galan-e/Tarjeta_v02/README.md

# Tarjeta_v02
<pre>Segunda Revision para la tarjeta de desarrollo con FPGA Spartan 6 
Los cambios realizados se centran en:
<ul>
<li> cambio de la IMU
<li> Agrego una tolerancia en borde de la tarjet
<li> Se agrandaron los agujeros de montaje.
<li> Acomodo de capacitores en alimentacion de cada banco del FPGA 
<li> Acomodo de capacitores en la alimentacion de todos los componentes.
</ul>
</pre>
<pre>Se han revisado y corregido los errores en el pcb

<ul>
<li> Trazos pequeños
<li> Trazos cerca de vias
<li> Tolerancia en tre trazos
<li> Nets no conectadas
</ul>
</pre>
