galan-e/Tarjeta_v02/KiCad-project/obi1/README.md

# KiCad Project

The file obi.sch is the main schematic sheet and contains the links to the schematic sheets of all components.
