galan-e/Tarjeta_v02/BOM_Tarjetav2.xlsx

Número de pieza del fabricante | Fabricante | Número de pieza de Digi-Key | Referencia del cliente | Designador de referencia | Embalaje | Estado de la pieza | Cantidad | Precio unitario | Precio total | Cantidad disponible | Tiempo esper. de fabricación: | Descripción | Estado RoHS | Estado Libre de plomo | Estatus REACH
AZ1117EH-3.3TRG1 | Diodes Incorporated | AZ1117EH-3.3TRG1DICT-ND |  |  | Cinta cortada (CT) | Última compra | 3 | 0.44 | $1.32 | 1476 | 17 Semanas | IC REG LINEAR 3.3V 1A SOT223 | Cumple con RoHS3 | Sin plomo | No afectado por REACH
AZ1117EH-1.2TRG1 | Diodes Incorporated | AZ1117EH-1.2TRG1DICT-ND |  |  | Cinta cortada (CT) | Última compra | 3 | 0.44 | $1.32 | 35 | 13 Semanas | IC REG LINEAR 1.2V 1A SOT223 | Cumple con RoHS3 | Sin plomo | No afectado por REACH
MCP4922T-E/ST | Microchip Technology | MCP4922T-E/STCT-ND |  |  | Cinta cortada (CT) | Activo | 3 | 2.75 | $8.25 | 8 | 38 Semanas | IC DAC 12BIT V-OUT 14TSSOP | Cumple con RoHS3 | Sin plomo | No afectado por REACH
ADC122S625CIMM/NOPB | Texas Instruments | ADC122S625CIMM/NOPBCT-ND |  |  | Cinta cortada (CT) | Activo | 3 | 6.94 | $20.82 | 1016 | 6 Semanas | IC ADC 12BIT SAR 10VSSOP | Cumple con RoHS3 | Sin plomo | No afectado por REACH
CY62157EV30LL-45ZSXIT | Cypress Semiconductor Corp | 428-3574-1-ND |  |  | Cinta cortada (CT) | Activo | 3 | 9.55 | $28.65 | 2251 | 15 Semanas | IC SRAM 8MBIT PARALLEL 44TSOP II | Cumple con RoHS3 | Sin plomo | No afectado por REACH
S25FL064LABMFM013 | Cypress Semiconductor Corp | 428-S25FL064LABMFM013CT-ND |  |  | Cinta cortada (CT) | Activo | 3 | 3.18 | $9.54 | 3306 | 20 Semanas | IC FLASH 64MBIT SPI/QUAD 8SOIC | Cumple con RoHS3 | Sin plomo | No afectado por REACH
CL21A475KQFNNNG | Samsung Electro-Mechanics | 1276-6465-1-ND |  |  | Cinta cortada (CT) | Activo | 60 | 0.0528 | $3.16 | 166338 | 28 Semanas | CAP CER 4.7UF 6.3V X5R 0805 | Cumple con RoHS3 | Sin plomo | No afectado por REACH
CL05A474KQ5NNNC | Samsung Electro-Mechanics | 1276-1479-1-ND |  |  | Cinta cortada (CT) | Activo | 60 | 0.0342 | $2.05 | 688810 | 28 Semanas | CAP CER 0.47UF 6.3V X5R 0402 | Cumple con RoHS3 | Sin plomo | No afectado por REACH
CL32A107MQVNNNE | Samsung Electro-Mechanics | 1276-1092-1-ND |  |  | Cinta cortada (CT) | Activo | 15 | 0.499 | $7.48 | 447304 | 28 Semanas | CAP CER 100UF 6.3V X5R 1210 | Cumple con RoHS3 | Sin plomo | No afectado por REACH
C0805Y103K9RAC7800 | KEMET | 399-17649-1-ND |  |  | Cinta cortada (CT) | Activo | 3 | 0.43 | $1.29 | 2081 | 20 Semanas | CAP CER SMD 0805 .01UF 6.3V 10% | Cumple con RoHS3 | Sin plomo | No afectado por REACH
CL21A106MQFNNNE | Samsung Electro-Mechanics | 1276-1298-1-ND |  |  | Cinta cortada (CT) | Activo | 3 | 0.11 | $0.33 | 1153 | 28 Semanas | CAP CER 10UF 6.3V X5R 0805 | Cumple con RoHS3 | Sin plomo | No afectado por REACH
08056D104KAT2A | AVX Corporation | 478-08056D104KAT2ACT-ND |  |  | Cinta cortada (CT) | Activo | 10 | 0.067 | $0.67 | 27701 | 16 Semanas | CAP CER 0.1UF 6.3V X5R 0805 | Cumple con RoHS3 | No disponible | No afectado por REACH
0603ZC124KAT2A | AVX Corporation | 478-1240-1-ND |  |  | Cinta cortada (CT) | Activo | 3 | 0.35 | $1.05 | 3499 | 24 Semanas | CAP CER 0.12UF 10V X7R 0603 | Cumple con RoHS3 | Sin plomo | No afectado por REACH
885012206013 | Würth Elektronik | 732-7932-1-ND |  |  | Cinta cortada (CT) | Activo | 10 | 0.021 | $0.21 | 4040 | 27 Semanas | CAP CER 6800PF 10V X7R 0603 | Cumple con RoHS3 | Sin plomo | No afectado por REACH
74LVC4245APW,118 | Nexperia USA Inc. | 1727-4308-1-ND |  |  | Cinta cortada (CT) | Activo | 6 | 0.59 | $3.54 | 18125 | 16 Semanas | IC TRNSLTR BIDIRECTIONAL 24TSSOP | Cumple con RoHS3 | Sin plomo | No afectado por REACH
XLH536060.000000I | Renesas Electronics America Inc | 631-1167-ND |  |  | Tira | Activo | 3 | 2 | $6.00 | 1717 | 20 Semanas | XTAL OSC XO 60.0000MHZ HCMOS SMD | Cumple con RoHS3 | Sin plomo | No afectado por REACH
10118193-0001LF | Amphenol ICC (FCI) | 609-4616-1-ND |  |  | Cinta cortada (CT) | Activo | 3 | 0.44 | $1.32 | 75865 | 14 Semanas | CONN RCPT USB2.0 MICRO B SMD R/A | Cumple con RoHS | Sin plomo | No afectado por REACH
PTS647SN38SMTR2LFS | C&K | PTS647SN38SMTR2LFSCT-ND |  |  | Cinta cortada (CT) | Activo | 6 | 0.18 | $1.08 | 77248 | 13 Semanas | TACT 4.5 X 4.5, 3.8 MM H, 1.0N, | Cumple con RoHS3 | Sin plomo | No disponible
CC0805KKX5R5BB105 | Yageo | 311-3417-1-ND |  |  | Cinta cortada (CT) | Activo | 50 | 0.0802 | $4.01 | 831 | 24 Semanas | CAP CER 1UF 6.3V X5R 0805 | Cumple con RoHS3 | Sin plomo | No afectado por REACH
CRCW08051M00FKEAHP | Vishay Dale | 541-1.00MTCT-ND |  |  | Cinta cortada (CT) | Activo | 3 | 0.26 | $0.78 | 8909 | 46 Semanas | RES SMD 1M OHM 1% 1/2W 0805 | Cumple con RoHS3 | Sin plomo | No disponible
RNCP0805FTD100R | Stackpole Electronics Inc | RNCP0805FTD100RCT-ND |  |  | Cinta cortada (CT) | Activo | 100 | 0.0283 | $2.83 | 233538 | 15 Semanas | RES 100 OHM 1% 1/4W 0805 | Cumple con RoHS3 | Sin plomo | No afectado por REACH
SG73S2ATTD4701F | KOA Speer Electronics, Inc. | 2019-SG73S2ATTD4701FCT-ND |  |  | Cinta cortada (CT) | Activo | 27 | 0.158 | $4.26 | 19836 | 8 Semanas | RES 4.7K OHM 1% 1/4W 0805 | Cumple con RoHS3 | Sin plomo | No afectado por REACH
RC0805FR-7W330RL | Yageo | 13-RC0805FR-7W330RLCT-ND |  |  | Cinta cortada (CT) | Activo | 3 | 0.18 | $0.54 | 6247 | 20 Semanas | RES 330 OHM 1% 1/4W 0805 | Cumple con RoHS3 | No disponible | No afectado por REACH
RK73B2ATTD510J | KOA Speer Electronics, Inc. | 2019-RK73B2ATTD510JCT-ND |  |  | Cinta cortada (CT) | Activo | 18 | 0.028 | $0.50 | 2213 | 7 Semanas | RES 51 OHM 5% 1/4W 0805 | Cumple con RoHS3 | Sin plomo | No afectado por REACH
RNCP0805FTD20R0 | Stackpole Electronics Inc | RNCP0805FTD20R0CT-ND |  |  | Cinta cortada (CT) | Activo | 24 | 0.07 | $1.68 | 31805 | 15 Semanas | RES 20 OHM 1% 1/4W 0805 | Cumple con RoHS3 | Sin plomo | No afectado por REACH
RK73H2ATTD2401F | KOA Speer Electronics, Inc. | 2019-RK73H2ATTD2401FCT-ND |  |  | Cinta cortada (CT) | Activo | 3 | 0.1 | $0.30 | 87 | 7 Semanas | RES 2.4K OHM 1% 1/4W 0805 | Cumple con RoHS3 | Sin plomo | No afectado por REACH
CRS0805-FX-10R0ELF | Bourns Inc. | CRS0805-FX-10R0ELFCT-ND |  |  | Cinta cortada (CT) | Activo | 3 | 0.21 | $0.63 | 15458 | 18 Semanas | RES SMD 10 OHM 1% 1/4W 0805 | Cumple con RoHS3 | Sin plomo | No afectado por REACH
LSM6DSMTR | STMicroelectronics | 497-16696-1-ND |  |  | Cinta cortada (CT) | Activo | 3 | 3.09 | $9.27 | 30433 | 34 Semanas | IMU ACCEL/GYRO I2C/SPI 14LGA | Cumple con RoHS3 | Sin plomo | No afectado por REACH
XC6SLX16-3FTG256I | Xilinx Inc. | 122-1730-ND |  |  | Bandeja | Activo | 3 | 41.86 | $125.58 | 2099 | 52 Semanas | IC FPGA 186 I/O 256FTBGA | Cumple con RoHS3 | Sin plomo | No afectado por REACH
DS01C-254-S-08BE | CUI Devices | 2223-DS01C-254-S-08BE-ND |  |  | Tubo | Activo | 3 | 0.66 | $1.98 | 325 | 8 Semanas | DIP SWITCH, SPST, 2.54 PITCH, RA | Cumple con RoHS | Sin plomo | No disponible
APG1608ZGCK | Kingbright | 754-2113-1-ND |  |  | Cinta cortada (CT) | Activo | 27 | 0.386 | $10.42 | 16355 | 8 Semanas | LED GREEN CLEAR 0603 SMD | Cumple con RoHS3 | Sin plomo | No afectado por REACH
RNCP0805FTD10K0 | Stackpole Electronics Inc | RNCP0805FTD10K0CT-ND |  |  | Cinta cortada (CT) | Activo | 10 | 0.07 | $0.70 | 147261 | 15 Semanas | RES 10K OHM 1% 1/4W 0805 | Cumple con RoHS3 | Sin plomo | No afectado por REACH
