galan-e/Tarjeta_v02/Component_List.ods

Sheet: Hoja1
Componente | Nombre | Pines | Comp. Req. | Link
Regulador 3.3V | AZ1117E3.3 | 3 | 2X1.0uF | https://www.digikey.com.mx/product-detail/es/AZ1117EH-3.3TRG1/AZ1117EH-3.3TRG1DICT-ND/5001336/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
Regulador 1.2V | AZ1117E1.2 | 3 | 2X1.0uF | https://www.digikey.com.mx/product-detail/es/AZ1117EH-1.2TRG1/AZ1117EH-1.2TRG1DICT-ND/5001340/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
Flash SOIC8 | S25FL064LABMFI013 | 8 |  | https://www.digikey.com.mx/product-detail/es/S25FL064LABMFI013/428-4073-1-ND/7318403/?itemSeq=302380495
FPGA | XC6SLX16-2FTG256C | 186 |  | https://www.digikey.com.mx/product-detail/es/XC6SLX16-2FTG256C/122-1672-ND/2408282/?itemSeq=302162759
IMU | BMX055 | 20 | 2x100nF | https://www.digikey.com.mx/product-detail/es/BMX055/828-1060-1-ND/6136311/?itemSeq=302382329
DAC | MCP4922T-E/ST | 14 | 0.1uF ceramic, 10uF tantalum in parallel | https://www.digikey.com.mx/product-detail/es/MCP4922T-E%2FST/MCP4922T-E%2FSTCT-ND/736004/?itemSeq=302284305
ADC | ADC122S625CIMM/NOPB | 10 | 2x10uF, 2x0.1uF | https://www.digikey.com.mx/product-detail/es/ADC122S625CIMM%2FNOPB/ADC122S625CIMM%2FNOPBCT-ND/1823877/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
ADC-OK | ADC122S021CIMM/NOPB |  |  | https://www.digikey.com.mx/product-detail/es/texas-instruments/ADC122S021CIMM-NOPB/ADC122S021CIMM-NOPBTR-ND/755010
RAM | CY62157EV30LL-45ZSXA | 44 |  | https://www.digikey.com.mx/product-detail/es/cypress-semiconductor-corp/CY7C1041GN30-10BVXI/2015-CY7C1041GN30-10BVXI-ND/9771559
FLASH Adesto Recomendada | AT45DB161E-SSHF2B-T | 8 |  | https://www.digikey.com.mx/product-detail/es/AT45DB161E-MHF2B-T/1265-1040-1-ND/3986539/?itemSeq=302596312
Capacitores Desacoplo Ver ug393_pag14 | CL21A475KQFNNNG CAP CER 4.7UF 6.3V X5R 0805 | 10x2 | 4.7uF | https://www.digikey.com.mx/ordering/shoppingcart?qty=5&cref=&enterprise=0&part=1276-6465-1-ND&partid=5958093
 | CL05A474KQ5NNNC CAP CER 0.47UF 6.3V X5R 0402 | 9x2 | 0.47uF | https://www.digikey.com.mx/product-detail/es/samsung-electro-mechanics/CL05A474KQ5NNNC/1276-1479-1-ND/3889565
 | CL32A107MQVNNNE CAP CER 100UF 6.3V X5R 1210 | 5x2 | 100uF | https://www.digikey.com.mx/product-detail/es/samsung-electro-mechanics/CL32A107MQVNNNE/1276-1092-1-ND/3889178
DIP Switch 8 | 206-8 | 16 |  | https://www.digikey.com.mx/product-detail/es/206-8/CT2068-ND/20760/?itemSeq=303884575
Variador de Nivel | 74LVC4245APW,118‎ | 24 |  | https://www.digikey.com.mx/product-detail/es/74LVC4245APW%2C118/1727-4308-1-ND/2209918/?itemSeq=304138377
Cristal | XLH536060.000000I‎ | 6 |  | https://www.digikey.com.mx/product-detail/es/XLH536060.000000I/631-1167-ND/2074695/?itemSeq=305209256
RAM2 | IS61WV25616EDBLL-10TLI‎ | 44 |  | https://www.digikey.com.mx/product-detail/es/IS61WV25616EDBLL-10TLI/706-1146-ND/2799144/?itemSeq=303374271
Terminales | OSTTC022162 | 2 |  | https://www.digikey.com.mx/product-detail/es/on-shore-technology-inc/OSTTC022162/ED2609-ND/614558
Micro usb conector | 10118193-0001LF | 5 |  | https://www.digikey.com.mx/product-detail/es/amphenol-icc-fci/10118193-0001LF/609-4616-1-ND/2785380
boton pulsador |  | 4 |  | https://www.digikey.com.mx/product-detail/es/PTS+647+SN38+SMTR2+LFS/PTS647SN38SMTR2LFSCT-ND/9649869/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
Led Verde |  | 2 |  | https://www.digikey.com.mx/product-detail/es/LTST-C191KGKT/160-1446-1-ND/386834/?itemSeq=303514635
Led Rojo |  | 2 |  | https://www.digikey.com.mx/product-detail/es/LTST-C191KRKT/160-1447-1-ND/386836/?itemSeq=303514649
Led Azul |  | 2 |  | https://www.digikey.com.mx/product-detail/es/LTST-C191TBKT/160-1647-1-ND/573587/?itemSeq=303514652

Sheet: BOM
Componente | @Caracteristica | Numero de parte | Link | Precio | Precio x10 | Reemplazo | Comp. Req. | Link | Precio Unitario | Precio x 5 | Precio x10
Regulador lineal | IC REG LINEAR 3.3V 1A SOT223 | AZ1117E3.3 | https://www.digikey.com.mx/product-detail/es/AZ1117EH-3.3TRG1/AZ1117EH-3.3TRG1DICT-ND/5001336/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 | $0.4400 | $0.3300
Regulador lineal | IC REG LINEAR 1.2V 1A SOT223 | AZ1117E1.2 | https://www.digikey.com.mx/product-detail/es/AZ1117EH-1.2TRG1/AZ1117EH-1.2TRG1DICT-ND/5001340/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 | $0.4400 | $0.3300
Flash | IC FLASH 64MBIT SPI/QUAD 8SOIC | S25FL064LABMFI013 | https://www.digikey.com.mx/product-detail/es/S25FL064LABMFI013/428-4073-1-ND/7318403/?itemSeq=302380495 | $1.4300 | $1.3040
FPGA | IC FPGA 186 I/O 256FTBGA | XC6SLX16-2FTG256C | https://www.digikey.com.mx/product-detail/es/XC6SLX16-2FTG256C/122-1672-ND/2408282/?itemSeq=302162759 | $26.4600 | $0.0000
IMU | Acelerómetro, giroscopio, magnetómetro, 9 ejes Sensor I²C, UART Salida | BMX055 | https://www.digikey.com.mx/product-detail/es/BMX055/828-1060-1-ND/6136311/?itemSeq=302382329 | $0.0000 | $0.0000 | BMF055 |  | https://www.digikey.com.mx/es/products/detail/bosch-sensortec/BMF055/6136302 | $10.9700 | $9.6240 | $8.6620
DAC | IC DAC 12BIT V-OUT 14TSSOP | MCP4922T-E/ST | https://www.digikey.com.mx/product-detail/es/MCP4922T-E%2FST/MCP4922T-E%2FSTCT-ND/736004/?itemSeq=302284305 | $2.7500 | $0.0000
ADC | IC ADC 12BIT SAR 10VSSOP | ADC122S625CIMM/NOPB | https://www.digikey.com.mx/product-detail/es/ADC122S625CIMM%2FNOPB/ADC122S625CIMM%2FNOPBCT-ND/1823877/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 | $6.9400 | $6.2670
ADC | IC ADC 12BIT SAR 8VSSOP | ADC122S021CIMM/NOPB | https://www.digikey.com.mx/product-detail/es/texas-instruments/ADC122S021CIMM-NOPB/ADC122S021CIMM-NOPBTR-ND/755010
SRAM | IC SRAM 8MBIT PARALLEL 44TSOP II | CY62157EV30LL-45ZSXA | https://www.digikey.com.mx/product-detail/es/cypress-semiconductor-corp/CY7C1041GN30-10BVXI/2015-CY7C1041GN30-10BVXI-ND/9771559 | $8.9000 | $8.1920 | CY62157EV30LL-45ZSXIT |  | https://www.digikey.com.mx/es/products/detail/cypress-semiconductor-corp/CY62157EV30LL-45ZSXIT/1205268 | $8.9000 | $0.0000 | $8.0212
Flash | IC FLASH 16MBIT SPI 85MHZ 8UDFN | AT45DB161E-SSHF2B-T | https://www.digikey.com.mx/product-detail/es/AT45DB161E-MHF2B-T/1265-1040-1-ND/3986539/?itemSeq=302596312 | $2.5900 | $2.3260
Capacitor | @4.7uF; 6.3V; X5R;0805;10%;CER | CL21A475KQFNNNG CAP CER 4.7UF 6.3V X5R 0805 | https://www.digikey.com.mx/ordering/shoppingcart?qty=5&cref=&enterprise=0&part=1276-6465-1-ND&partid=5958093 | $0.1300 | $0.0890
Capacitor | @0.47uF; 6.3V; X5R;0402;10%;CER | CL05A474KQ5NNNC CAP CER 0.47UF 6.3V X5R 0402 | https://www.digikey.com.mx/product-detail/es/samsung-electro-mechanics/CL05A474KQ5NNNC/1276-1479-1-ND/3889565 | $0.1000 | $0.0600
Capacitor | @100uF; 6.3V; X5R;1210;20%;CER | CL32A107MQVNNNE CAP CER 100UF 6.3V X5R 1210 | https://www.digikey.com.mx/product-detail/es/samsung-electro-mechanics/CL32A107MQVNNNE/1276-1092-1-ND/3889178 | $0.6700 | $0.4750
Capacitor | @0.01uF;6.3V;X7R;0805;10% | CAP CER SMD 0805 .01UF 6.3V 10% | https://www.digikey.com.mx/en/products/detail/kemet/C0805Y103K9RAC7800/8572484 | $0.4300 | $0.3020
Capacitor | @10uF;6.3V;X5R;0805;20% | CAP CER 10UF 6.3V X5R 0805 | https://www.digikey.com.mx/en/products/detail/samsung-electro-mechanics/CL21A106MQFNNNE/3886956 | $0.1100 | $0.0820
Capacitor | @0.1uF;6.3V;X5R;0805;10% | CAP CER 0.1UF 6.3V X5R 0805 | https://www.digikey.com.mx/en/products/detail/avx-corporation/08056D104KAT2A/11568656 | $0.1000 | $0.0600
Capacitor | @0.12uF;10V;X7R;0603;10% | CAP CER 0.12UF 10V X7R 0603 | https://www.digikey.com.mx/en/products/detail/avx-corporation/0603ZC124KAT2A/563350 | $0.3500 | $0.2420
Capacitor | @6800pF;10V;X7R;0603;10% | CAP CER 6800PF 10V X7R 0603 | https://www.digikey.com.mx/en/products/detail/w%C3%BCrth-elektronik/885012206013/5453787 | $0.1000 | $0.0210
DIP SW | SWITCH SLIDE DIP SPST 50MA 24V | 206-8 | https://www.digikey.com.mx/product-detail/es/206-8/CT2068-ND/20760/?itemSeq=303884575 | $0.9000 | $0.8630
Traductor Voltaje | IC TRNSLTR BIDIRECTIONAL 24TSSOP | 74LVC4245APW,118‎ | https://www.digikey.com.mx/product-detail/es/74LVC4245APW%2C118/1727-4308-1-ND/2209918/?itemSeq=304138377 | $0.5900 | $0.5170
Oscilador | XTAL OSC XO 60.0000MHZ HCMOS SMD | XLH536060.000000I‎ | https://www.digikey.com.mx/product-detail/es/XLH536060.000000I/631-1167-ND/2074695/?itemSeq=305209256 | $1.9100 | $1.8290
SRAM | IC SRAM 4MBIT PARALLEL 44TSOP II | IS61WV25616EDBLL-10TLI‎ | https://www.digikey.com.mx/product-detail/es/IS61WV25616EDBLL-10TLI/706-1146-ND/2799144/?itemSeq=303374271 | $3.2100 | $2.8840
Terminal | TERM BLK 2P SIDE ENT 5.08MM PCB | OSTTC022162 | https://www.digikey.com.mx/product-detail/es/on-shore-technology-inc/OSTTC022162/ED2609-ND/614558 | $0.8000 | $0.4370
microUSB | CONN RCPT USB2.0 MICRO B SMD R/A | 10118193-0001LF | https://www.digikey.com.mx/product-detail/es/amphenol-icc-fci/10118193-0001LF/609-4616-1-ND/2785380 | $0.4800 | $0.4510
Push BT | TACT 4.5 X 4.5, 3.8 MM H, 1.0N, | PTS647SN38SMTR2LFS | https://www.digikey.com.mx/product-detail/es/PTS+647+SN38+SMTR2+LFS/PTS647SN38SMTR2LFSCT-ND/9649869/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 | $0.1800 | $0.1770
LED Green | @LED;GRE;0603 | LTST-C191KGKT | https://www.digikey.com.mx/product-detail/es/LTST-C191KGKT/160-1446-1-ND/386834/?itemSeq=303514635 | $0.2600 | $0.1410
LED Red | @LED;RED;0603 | LTST-C191KRKT | https://www.digikey.com.mx/product-detail/es/LTST-C191KRKT/160-1447-1-ND/386836/?itemSeq=303514649 | $0.2600 | $0.1410
LED Blue | @LED;BLU;0603 | LTST-C191TBKT | https://www.digikey.com.mx/product-detail/es/LTST-C191TBKT/160-1647-1-ND/573587/?itemSeq=303514652 | $0.3300 | $0.2620
Capacitor | @1uF; 6.3V; X5R;0805;10%;CER | CC0805KKX5R5BB105 | https://www.digikey.com.mx/es/products/detail/yageo/CC0805KKX5R5BB105/5884149 | $0.1900 | $0.1280
Oscilador imu | XTAL OSC XO 32.768KHZ HCMOS SMD | CO2520-0.032768-3.3-50-X-TR | https://www.digikey.com.mx/es/products/detail/raltron-electronics/CO2520-0-032768-3-3-50-X-TR/10246244 | $1.4600
Resistor | @1M;1/2W;0805;1% | RES SMD 1M OHM 1% 1/2W 0805 | https://www.digikey.com.mx/es/products/detail/vishay-dale/CRCW08051M00FKEAHP/2222364 | $0.2600 | $0.2210
Resistor | @100;1/4W;0805;1% | RES 100 OHM 1% 1/4W 0805 | https://www.digikey.com.mx/es/products/detail/stackpole-electronics-inc/RNCP0805FTD100R/2240209 | $0.1000 | $0.0700
Resistor | @4.7K;1/4W;0805;1% | RES 4.7K OHM 1% 1/4W 0805 | https://www.digikey.com.mx/es/products/detail/koa-speer-electronics-inc/SG73S2ATTD4701F/10279923 | $0.1900 | $0.1580
Resistor | @330;1/4W;0805;1% | RES 330 OHM 1% 1/4W 0805 | https://www.digikey.com.mx/es/products/detail/yageo/RC0805FR-7W330RL/12698865 | $0.1800 | $1.5300
Resistor | @51;1/4W;0805;5% | RES 51 OHM 5% 1/4W 0805 | https://www.digikey.com.mx/es/products/detail/koa-speer-electronics-inc/RK73B2ATTD510J/10236476 | $0.1000 | $0.0280
Resistor | @20;1/4W;0805;1% | RES 20 OHM 1% 1/4W 0805 | https://www.digikey.com.mx/es/products/detail/stackpole-electronics-inc/RNCP0805FTD20R0/2240199 | $0.1000 | $0.0700
Resistor | @2.4K;1/4W;0805;1% | RES 2.4K OHM 1% 1/4W 0805 | https://www.digikey.com.mx/es/products/detail/koa-speer-electronics-inc/RK73H2ATTD2401F/10234257 | $0.1000 | $0.0350
Resistor | @10K;1/4W;0805;1% | RES 10K OHM 1% 1/4W 0805 | https://www.digikey.com.mx/es/products/detail/koa-speer-electronics-inc/RK73H2ATTE1002F/11476556 | $0.1000 | $0.0400
Resistor | @10;1/4W;0805;1% | RES SMD 10 OHM 1% 1/4W 0805 | https://www.digikey.com.mx/es/products/detail/bourns-inc/CRS0805-FX-10R0ELF/5778644

Sheet: Sheet3
Componente | Cantidad | Cantidad para Tarjetas Requeridas | @Caracteristica | Numero de parte | Link DigiKey | Datasheet | Precio | Total x Pza |  |  | Alternative Vendor | Precio
Regulador lineal | 1 | 3 | IC REG LINEAR 3.3V 1A SOT223 | AZ1117E3.3 | https://www.digikey.com.mx/product-detail/es/AZ1117EH-3.3TRG1/AZ1117EH-3.3TRG1DICT-ND/5001336/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 | https://www.diodes.com/assets/Datasheets/AZ1117E.pdf | $0.4400 | $0.4400 |  |  | https://www.mouser.com/ProductDetail/Diodes-Incorporated/AZ1117EH-33TRG1?qs=5V6w%252be2aIqag5NKVFQwk%252bg== | $0.44
Regulador lineal | 1 | 3 | IC REG LINEAR 1.2V 1A SOT223 | AZ1117E1.2 | https://www.digikey.com.mx/product-detail/es/AZ1117EH-1.2TRG1/AZ1117EH-1.2TRG1DICT-ND/5001340/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 | https://www.diodes.com/assets/Datasheets/AZ1117E.pdf | $0.4400 | $0.4400 | Subtotal | $85.4800 | https://www.mouser.com/ProductDetail/Diodes-Incorporated/AZ1117EH-33TRG1?qs=5V6w%252be2aIqag5NKVFQwk%252bg== | $0.44
FPGA | 1 | 3 | IC FPGA 186 I/O 256FTBGA | XC6SLX16-2FTG256C | https://www.digikey.com.mx/product-detail/es/XC6SLX16-2FTG256C/122-1672-ND/2408282/?itemSeq=302162759 | https://www.xilinx.com/support/documentation/data_sheets/ds162.pdf | $26.4600 | $26.4600 | % Gracia | 20.00 | https://mexico.newark.com/xilinx/xc6slx16-2ftg256c/fpga-spartan-6-186-i-o-ftbga-256/dp/32AC9758?CMP=AFC-SF-FC | $31.44
IMU | 1 | 3 | Acelerómetro, giroscopio, magnetómetro, 9 ejes Sensor I²C, UART Salida | BMF055 | https://www.digikey.com.mx/es/products/detail/bosch-sensortec/BMF055/6136302 | https://www.bosch-sensortec.com/media/boschsensortec/downloads/datasheets/bst-bmf055-ds000.pdf | $10.9700 | $10.9700 |  |  | No hay
DAC | 1 | 3 | IC DAC 12BIT V-OUT 14TSSOP | MCP4922T-E/ST | https://www.digikey.com.mx/product-detail/es/MCP4922T-E%2FST/MCP4922T-E%2FSTCT-ND/736004/?itemSeq=302284305 | https://ww1.microchip.com/downloads/en/DeviceDoc/22250A.pdf | $2.7500 | $2.7500 | Total x Unidad con % de gracia | $102.5760 | https://www.arrow.com/en/products/mcp4922t-est/microchip-technology | $2.73
ADC | 1 | 3 | IC ADC 12BIT SAR 10VSSOP | ADC122S625CIMM/NOPB | https://www.digikey.com.mx/product-detail/es/ADC122S625CIMM%2FNOPB/ADC122S625CIMM%2FNOPBCT-ND/1823877/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 | https://www.ti.com/lit/ds/symlink/adc122s625.pdf?HQS=dis-dk-null-digikeymode-dsf-pf-null-wwe&ts=1618094382911 | $6.9400 | $6.9400 |  |  | https://www.mouser.com/ProductDetail/Texas-Instruments/ADC122S625CIMM-NOPB?qs=7X5t%252bdzoRHCqXIePHbrr1g%3D%3D | $6.94
SRAM | 1 | 3 | IC SRAM 8MBIT PARALLEL 44TSOP II | CY62157EV30LL-45ZSXIT | https://www.digikey.com.mx/es/products/detail/cypress-semiconductor-corp/CY62157EV30LL-45ZSXIT/1205268 | https://www.cypress.com/file/43021/download | $9.5500 | $9.5500 | Unidades Requeridas | 3 | https://www.mouser.com/ProductDetail/Cypress-Semiconductor/CY62157EV30LL-45ZSXI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 | $8.47
Flash | 1 | 3 | IC FLASH 64MBIT SPI/QUAD 8SOIC | S25FL064LABMFM013 | https://www.digikey.com.mx/es/products/detail/cypress-semiconductor-corp/S25FL064LABMFM013/7363009 | https://www.cypress.com/file/316661/download | $3.1800 | $3.1800 |  |  | https://www.mouser.com/ProductDetail/Cypress-Semiconductor/S25FL064LABMFM013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 | $2.93
Capacitor | 20 | 60 | @4.7uF; 6.3V; X5R;0805;10%;CER | CL21A475KQFNNNG CAP CER 4.7UF 6.3V X5R 0805 | https://www.digikey.com.mx/en/products/detail/CL21A475KQFNNNG/1276-6465-1-ND/5958093?itemSeq=361091110 |  | $0.1300 | $2.6000 | Total Aprox | $307.7280
Capacitor | 20 | 60 | @0.47uF; 6.3V; X5R;0402;10%;CER | CL05A474KQ5NNNC CAP CER 0.47UF 6.3V X5R 0402 | https://www.digikey.com.mx/product-detail/es/samsung-electro-mechanics/CL05A474KQ5NNNC/1276-1479-1-ND/3889565 |  | $0.1000 | $2.0000
Capacitor | 5 | 15 | @100uF; 6.3V; X5R;1210;20%;CER | CL32A107MQVNNNE CAP CER 100UF 6.3V X5R 1210 | https://www.digikey.com.mx/product-detail/es/samsung-electro-mechanics/CL32A107MQVNNNE/1276-1092-1-ND/3889178 |  | $0.6700 | $3.3500
Capacitor | 1 | 3 | @0.01uF;6.3V;X7R;0805;10% | CAP CER SMD 0805 .01UF 6.3V 10% | https://www.digikey.com.mx/en/products/detail/kemet/C0805Y103K9RAC7800/8572484 |  | $0.4300 | $0.4300
Capacitor | 1 | 3 | @10uF;6.3V;X5R;0805;20% | CAP CER 10UF 6.3V X5R 0805 | https://www.digikey.com.mx/en/products/detail/samsung-electro-mechanics/CL21A106MQFNNNE/3886956 |  | $0.1100 | $0.1100
Capacitor | 3 | 9 | @0.1uF;6.3V;X5R;0805;10% | CAP CER 0.1UF 6.3V X5R 0805 | https://www.digikey.com.mx/en/products/detail/avx-corporation/08056D104KAT2A/11568656 |  | $0.1000 | $0.3000
Capacitor | 1 | 3 | @0.12uF;10V;X7R;0603;10% | CAP CER 0.12UF 10V X7R 0603 | https://www.digikey.com.mx/en/products/detail/avx-corporation/0603ZC124KAT2A/563350 |  | $0.3500 | $0.3500
Capacitor | 1 | 3 | @6800pF;10V;X7R;0603;10% | CAP CER 6800PF 10V X7R 0603 | https://www.digikey.com.mx/en/products/detail/w%C3%BCrth-elektronik/885012206013/5453787 |  | $0.1000 | $0.1000
DIP SW | 1 | 3 | SWITCH SLIDE DIP SPST 50MA 24V | 206-8 | https://www.digikey.com.mx/product-detail/es/206-8/CT2068-ND/20760/?itemSeq=303884575 |  | $0.9000 | $0.9000 |  |  | https://www.digikey.com.mx/es/products/detail/cui-devices/DS01C-254-S-08BE/11310924 | $0.66
Traductor Voltaje | 2 | 6 | IC TRNSLTR BIDIRECTIONAL 24TSSOP | 74LVC4245APW,118‎ | https://www.digikey.com.mx/product-detail/es/74LVC4245APW%2C118/1727-4308-1-ND/2209918/?itemSeq=304138377 | https://assets.nexperia.com/documents/data-sheet/74LVC4245A.pdf | $0.5900 | $1.1800 |  |  | https://www.arrow.com/en/products/74lvc4245apw118/nexperia | $0.69
Oscilador | 1 | 3 | XTAL OSC XO 60.0000MHZ HCMOS SMD | XLH536060.000000I‎ | https://www.digikey.com.mx/product-detail/es/XLH536060.000000I/631-1167-ND/2074695/?itemSeq=305209256 | https://abracon.com/datasheets/Fox/FO5HS.pdf?utm_source=foxonline.com&utm_medium=301 | $1.9100 | $1.9100 |  |  | https://www.mouser.com/ProductDetail/Renesas-IDT/XLH536060000000I?qs=Sm3NkJ%2FXO7%252b58rZ9eR4rQg%3D%3D | $1.91
microUSB | 1 | 3 | CONN RCPT USB2.0 MICRO B SMD R/A | 10118193-0001LF | https://www.digikey.com.mx/product-detail/es/amphenol-icc-fci/10118193-0001LF/609-4616-1-ND/2785380 |  | $0.4800 | $0.4800
Push BT | 1 | 3 | TACT 4.5 X 4.5, 3.8 MM H, 1.0N, | PTS647SN38SMTR2LFS | https://www.digikey.com.mx/product-detail/es/PTS+647+SN38+SMTR2+LFS/PTS647SN38SMTR2LFSCT-ND/9649869/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 |  | $0.1800 | $0.1800
LED Green | 1 | 3 | @LED;GRE;0603 | LTST-C191KGKT | https://www.digikey.com.mx/product-detail/es/LTST-C191KGKT/160-1446-1-ND/386834/?itemSeq=303514635 |  | $0.2600 | $0.2600
LED Red | 0 | 0 | @LED;RED;0603 | LTST-C191KRKT | https://www.digikey.com.mx/product-detail/es/LTST-C191KRKT/160-1447-1-ND/386836/?itemSeq=303514649 |  | $0.2600 | $0.0000
LED Blue | 8 | 24 | @LED;BLU;0603 | LTST-C191TBKT | https://www.digikey.com.mx/product-detail/es/LTST-C191TBKT/160-1647-1-ND/573587/?itemSeq=303514652 |  | $0.3300 | $2.6400
Capacitor | 10 | 30 | @1uF; 6.3V; X5R;0805;10%;CER | CC0805KKX5R5BB105 | https://www.digikey.com.mx/es/products/detail/yageo/CC0805KKX5R5BB105/5884149 |  | $0.1900 | $1.9000
Resistor | 1 | 3 | @1M;1/2W;0805;1% | RES SMD 1M OHM 1% 1/2W 0805 | https://www.digikey.com.mx/es/products/detail/vishay-dale/CRCW08051M00FKEAHP/2222364 |  | $0.2600 | $0.2600
Resistor | 21 | 63 | @100;1/4W;0805;1% | RES 100 OHM 1% 1/4W 0805 | https://www.digikey.com.mx/es/products/detail/stackpole-electronics-inc/RNCP0805FTD100R/2240209 |  | $0.1000 | $2.1000
Resistor | 9 | 27 | @4.7K;1/4W;0805;1% | RES 4.7K OHM 1% 1/4W 0805 | https://www.digikey.com.mx/es/products/detail/koa-speer-electronics-inc/SG73S2ATTD4701F/10279923 |  | $0.1900 | $1.7100
Resistor | 1 | 3 | @330;1/4W;0805;1% | RES 330 OHM 1% 1/4W 0805 | https://www.digikey.com.mx/es/products/detail/yageo/RC0805FR-7W330RL/12698865 |  | $0.1800 | $0.1800
Resistor | 6 | 18 | @51;1/4W;0805;5% | RES 51 OHM 5% 1/4W 0805 | https://www.digikey.com.mx/es/products/detail/koa-speer-electronics-inc/RK73B2ATTD510J/10236476 |  | $0.1000 | $0.6000
Resistor | 8 | 24 | @20;1/4W;0805;1% | RES 20 OHM 1% 1/4W 0805 | https://www.digikey.com.mx/es/products/detail/stackpole-electronics-inc/RNCP0805FTD20R0/2240199 |  | $0.1000 | $0.8000
Resistor | 1 | 3 | @2.4K;1/4W;0805;1% | RES 2.4K OHM 1% 1/4W 0805 | https://www.digikey.com.mx/es/products/detail/koa-speer-electronics-inc/RK73H2ATTD2401F/10234257 |  | $0.1000 | $0.1000
Resistor | 1 | 3 | @10K;1/4W;0805;1% | RES 10K OHM 1% 1/4W 0805 | https://www.digikey.com.mx/es/products/detail/koa-speer-electronics-inc/RK73H2ATTE1002F/11476556 |  | $0.1000 | $0.1000 |  |  | https://www.digikey.com.mx/es/products/detail/stackpole-electronics-inc/RNCP0805FTD10K0/2240262 | $0.10
Resistor | 1 | 3 | @10;1/4W;0805;1% | RES SMD 10 OHM 1% 1/4W 0805 | https://www.digikey.com.mx/es/products/detail/bourns-inc/CRS0805-FX-10R0ELF/5778644 |  | $0.2100 | $0.2100
