galan-e/Tarjeta_v02/LIB_206-8/206-8/3D/206-8.stp

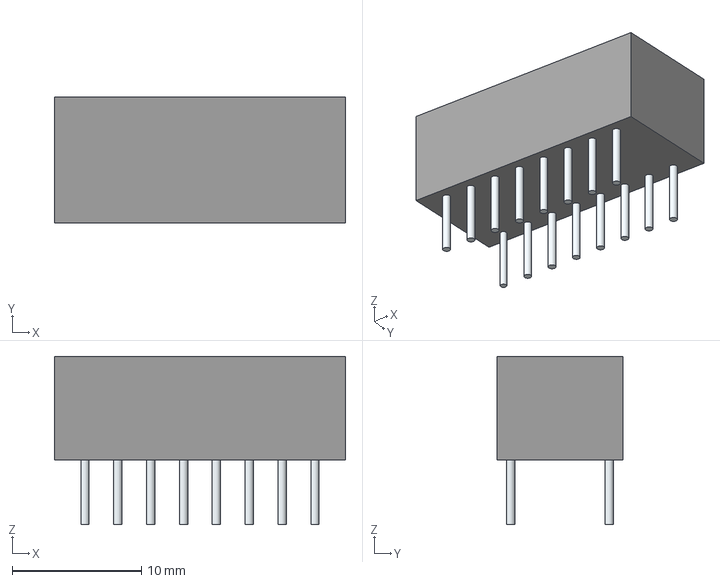
[picture p1: CAD file, 2021-03-30]
LIB_206-8/206-8/3D/206-8.stp
22.5 x 9.78 x 13.0 mm
Leads x 16
