galan-e/Tarjeta_v02/LIB_ADC122S625CIMM_NOPB/ADC122S625CIMM_NOPB/3D/ADC122S625CIMM_NOPB.stp

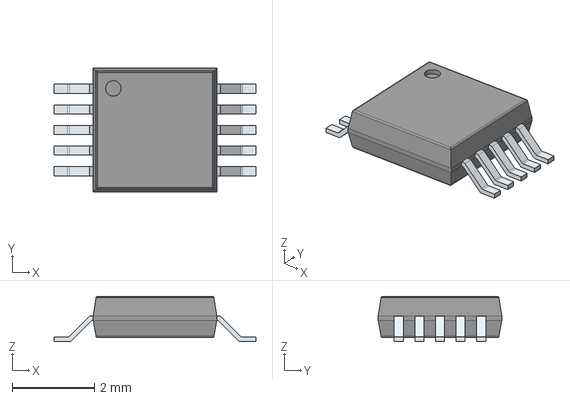
[picture p2: CAD file, 2021-03-30]
LIB_ADC122S625CIMM_NOPB/ADC122S625CIMM_NOPB/3D/ADC122S625CIMM_NOPB.stp
4.90 x 3.00 x 1.10 mm
PinsArrayLR
