galan-e/Tarjeta_v02/LIB_IS61WV25616EDBLL-10TLI/IS61WV25616EDBLL-10TLI/3D/IS61WV25616EDBLL-10TLI.stp

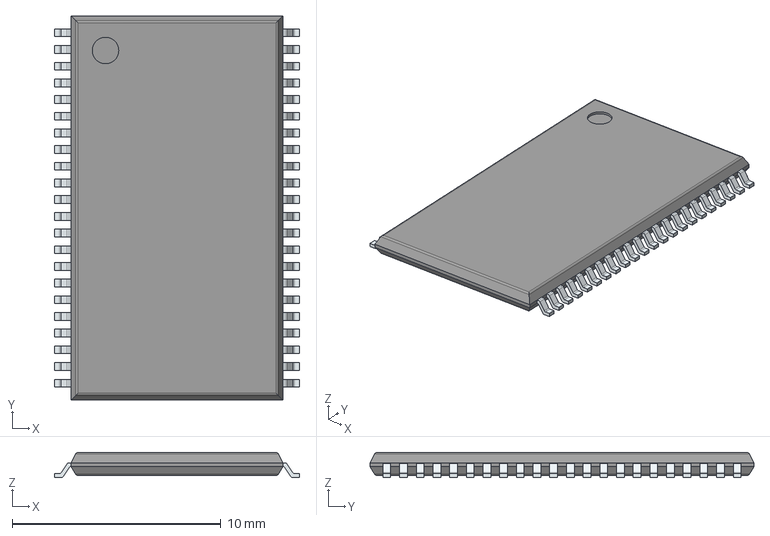
[picture p3: CAD file, 2021-03-30]
LIB_IS61WV25616EDBLL-10TLI/IS61WV25616EDBLL-10TLI/3D/IS61WV25616EDBLL-10TLI.stp
11.8 x 18.4 x 1.20 mm
PinsArrayLR
