galan-e/Tarjeta_v02/LIB_MCP4922T-E_ST/MCP4922T-E_ST/3D/MCP4922T-E_ST.stp

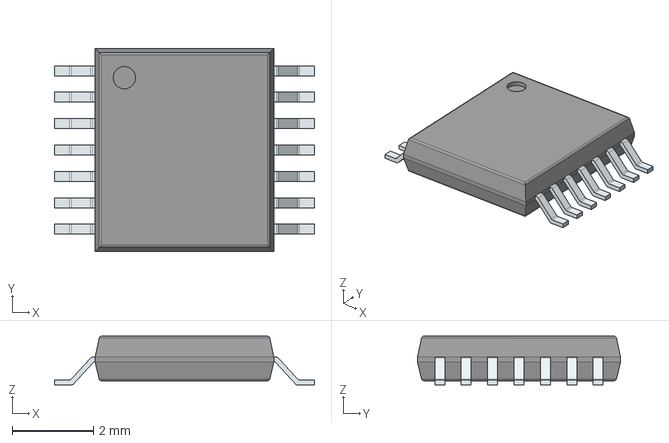
[picture p4: CAD file, 2021-03-30]
LIB_MCP4922T-E_ST/MCP4922T-E_ST/3D/MCP4922T-E_ST.stp
6.40 x 5.00 x 1.20 mm
PinsArrayLR
