galan-e/Tarjeta_v02/LIB_S25FL064LABMFI013/S25FL064LABMFI013/3D/S25FL064LABMFI013.stp

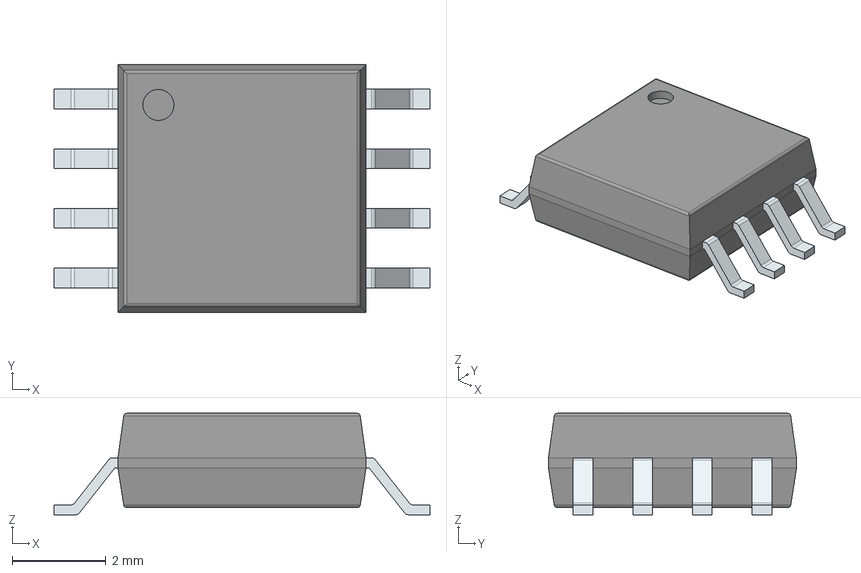
[picture p5: CAD file, 2021-03-30]
LIB_S25FL064LABMFI013/S25FL064LABMFI013/3D/S25FL064LABMFI013.stp
8.00 x 5.28 x 2.16 mm
PinsArrayLR
