galan-e/Tarjeta_v02/LSM6DSMTR/LSM6DSMTR.step

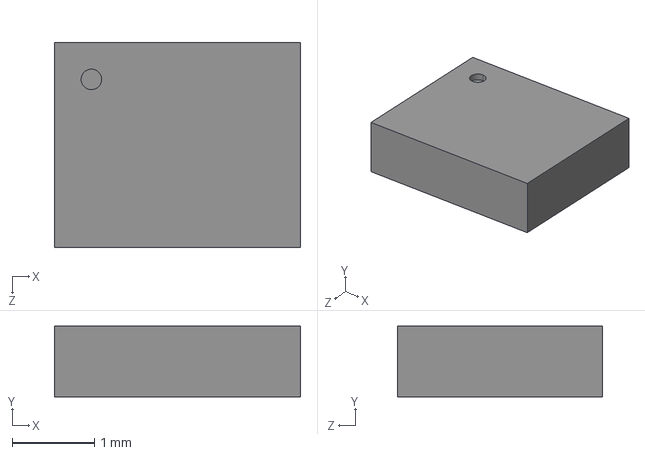
[picture p6: CAD file, 2021-04-30]
LSM6DSMTR/LSM6DSMTR.step
3.00 x 0.86 x 2.50 mm
