galan-e/Tarjeta_v02/LIB_10118193-0001LF/10118193-0001LF/3D/10118193-0001LF.stp

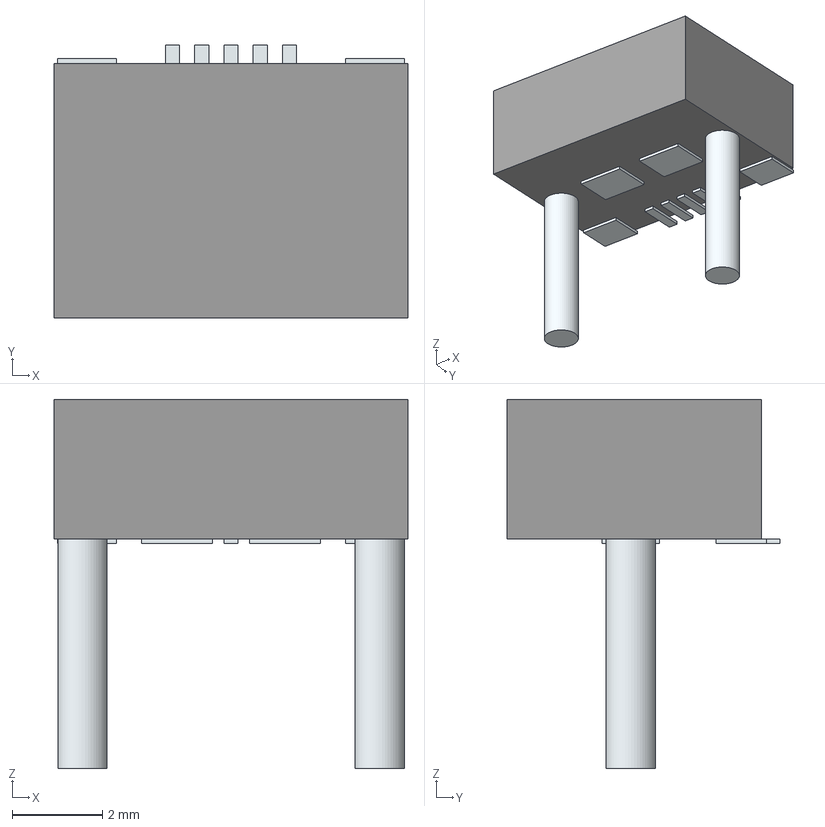
[picture p7: CAD file, 2021-03-30]
LIB_10118193-0001LF/10118193-0001LF/3D/10118193-0001LF.stp
7.86 x 6.06 x 8.20 mm
('pin',_'1')
('pin',_'2')
('pin',_'3')
('pin',_'4')
('pin',_'5')
('pin',_'6')
('pin',_'7')
('pin',_'8')
('pin',_'9')
Leads x 2
