galan-e/Tarjeta_v02/(list of files, cad)

Other CAD files:
LIB_10118193-0001LF/10118193-0001LF/3D/10118193-0001LF.stl
LIB_10118193-0001LF/10118193-0001LF/Allegro/101181930001lf.psm
LIB_10118193-0001LF/10118193-0001LF/DEHDL/10118193_0001lf/chips/chips.prt
LIB_206-8/206-8/Allegro/2068.psm
LIB_206-8/206-8/DEHDL/206_8/chips/chips.prt
LIB_ADC122S625CIMM_NOPB/ADC122S625CIMM_NOPB/3D/ADC122S625CIMM_NOPB.stl
LIB_ADC122S625CIMM_NOPB/ADC122S625CIMM_NOPB/Allegro/sop50p490x110-10n.psm
LIB_ADC122S625CIMM_NOPB/ADC122S625CIMM_NOPB/DEHDL/adc122s625cimm_nopb/chips/chips.prt
LIB_BMX055/BMX055/Allegro/lga_package_20_pins.psm
LIB_BMX055/BMX055/DEHDL/bmx055/chips/chips.prt
LIB_IS61WV25616EDBLL-10TLI/IS61WV25616EDBLL-10TLI/3D/IS61WV25616EDBLL-10TLI.stl
LIB_IS61WV25616EDBLL-10TLI/IS61WV25616EDBLL-10TLI/Allegro/sop80p1176x120-44n.psm
LIB_IS61WV25616EDBLL-10TLI/IS61WV25616EDBLL-10TLI/DEHDL/is61wv25616edbll_10tli/chips/chips.prt
LIB_MCP4922T-E_ST/MCP4922T-E_ST/3D/MCP4922T-E_ST.stl
LIB_MCP4922T-E_ST/MCP4922T-E_ST/Allegro/sop65p640x120-14n.psm
LIB_MCP4922T-E_ST/MCP4922T-E_ST/DEHDL/mcp4922t_e_st/chips/chips.prt
LIB_S25FL064LABMFI013/S25FL064LABMFI013/3D/S25FL064LABMFI013.stl
LIB_S25FL064LABMFI013/S25FL064LABMFI013/Allegro/soic127p800x216-8n.psm
LIB_S25FL064LABMFI013/S25FL064LABMFI013/DEHDL/s25fl064labmfi013/chips/chips.prt
