galan-e/Tarjeta_v02/KiCad-project/obi1/obi1.kicad_pcb

## KiCad design KiCad-project/obi1/obi1.kicad_pcb (2021-04-30)

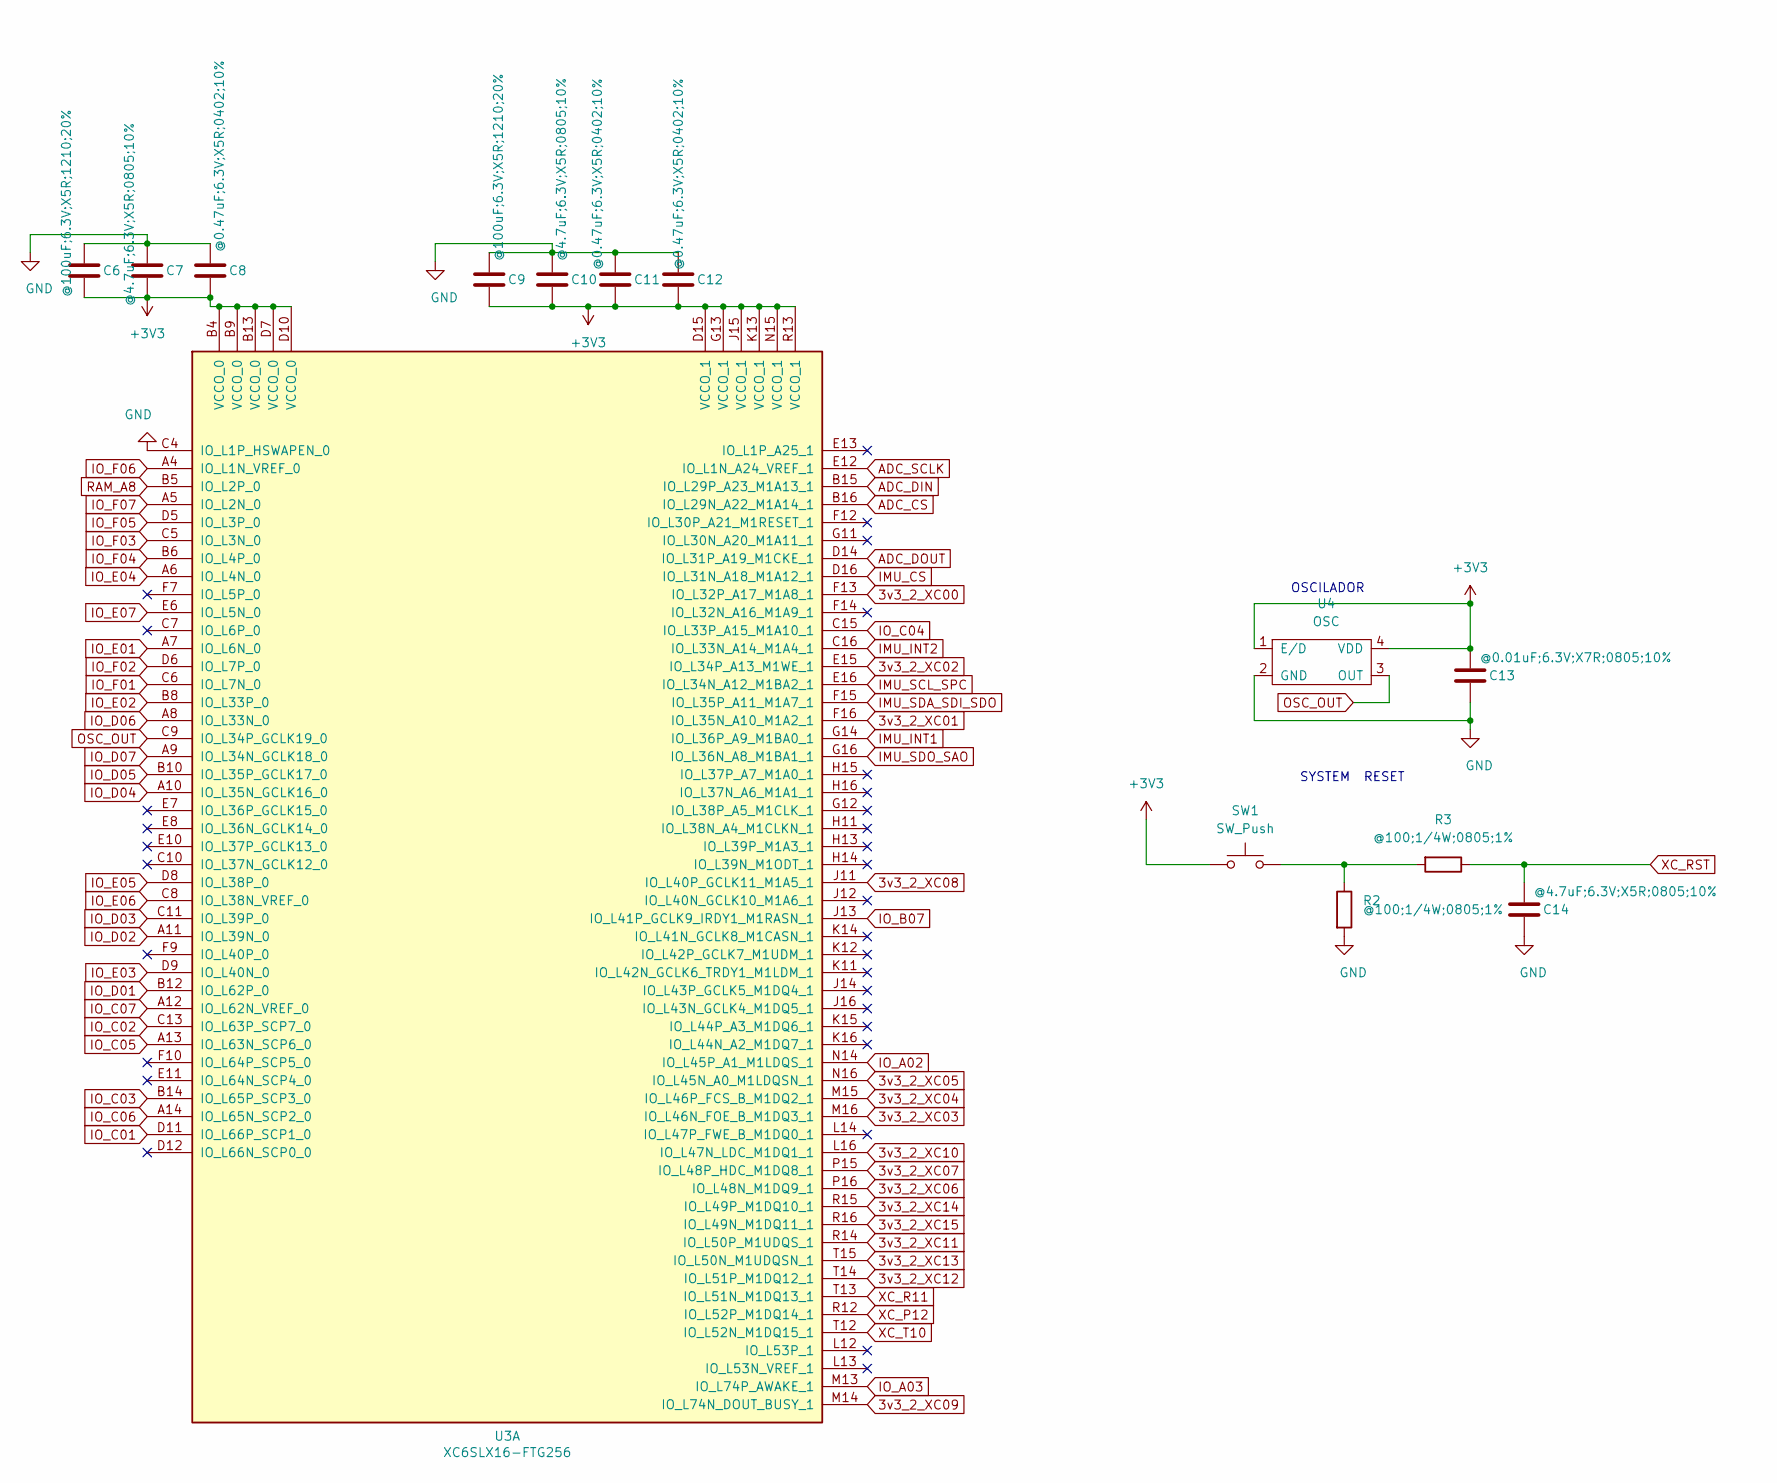
[picture p8: schematic FPGA_PartA.sch, Spartan6 FTG256 Part A]

Parts:
C6, C9: @100uF;6.3V;X5R;1210;20%; C_1210_3225Metric_Pad1.33x2.70mm_HandSolder
C7, C10, C14: @4.7uF;6.3V;X5R;0805;10%; C_0805_2012Metric_Pad1.18x1.45mm_HandSolder
C8, C11, C12: @0.47uF;6.3V;X5R;0402;10%; C_0402_1005Metric_Pad0.74x0.62mm_HandSolder
C13: @0.01uF;6.3V;X7R;0805;10%; C_0805_2012Metric_Pad1.18x1.45mm_HandSolder
R2, R3: @100;1/4W;0805;1%; R_0805_2012Metric_Pad1.20x1.40mm_HandSolder
SW1: SW_Push; SW_Push_1P1T_NO_6x6mm_H9.5mm
U3: XC6SLX16-FTG256; BGA-256_17.0x17.0mm_Layout16x16_P1.0mm_Ball0.5mm_Pad0.4mm_N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
U4: OSC; Oscillator_XLH536025.000000I

Connections:
3v3_2_XC00: U3.F13 (IO_L32P_A17_M1A8_1); also elsewhere on the board
3v3_2_XC01: U3.F16 (IO_L35N_A10_M1A2_1); also elsewhere on the board
3v3_2_XC02: U3.E15 (IO_L34P_A13_M1WE_1); also elsewhere on the board
3v3_2_XC03: U3.M16 (IO_L46N_FOE_B_M1DQ3_1); also elsewhere on the board
3v3_2_XC04: U3.M15 (IO_L46P_FCS_B_M1DQ2_1); also elsewhere on the board
3v3_2_XC05: U3.N16 (IO_L45N_A0_M1LDQSN_1); also elsewhere on the board
3v3_2_XC06: U3.P16 (IO_L48N_M1DQ9_1); also elsewhere on the board
3v3_2_XC07: U3.P15 (IO_L48P_HDC_M1DQ8_1); also elsewhere on the board
3v3_2_XC08: U3.J11 (IO_L40P_GCLK11_M1A5_1); also elsewhere on the board
3v3_2_XC09: U3.M14 (IO_L74N_DOUT_BUSY_1); also elsewhere on the board
3v3_2_XC10: U3.L16 (IO_L47N_LDC_M1DQ1_1); also elsewhere on the board
3v3_2_XC11: U3.R14 (IO_L50P_M1UDQS_1); also elsewhere on the board
3v3_2_XC12: U3.T14 (IO_L51P_M1DQ12_1); also elsewhere on the board
3v3_2_XC13: U3.T15 (IO_L50N_M1UDQSN_1); also elsewhere on the board
3v3_2_XC14: U3.R15 (IO_L49P_M1DQ10_1); also elsewhere on the board
3v3_2_XC15: U3.R16 (IO_L49N_M1DQ11_1); also elsewhere on the board
+3V3: C6.2, C7.2, C8.2, C9.2, C10.2, C11.2, C12.2, C13.1, SW1.1, U3.B4 (VCCO_0), U3.B9 (VCCO_0), U3.B13 (VCCO_0), U3.D7 (VCCO_0), U3.D10 (VCCO_0), U3.D15 (VCCO_1), U3.G13 (VCCO_1), U3.J15 (VCCO_1), U3.K13 (VCCO_1), U3.N15 (VCCO_1), U3.R13 (VCCO_1), U4.1 (E/D), U4.4 (VDD); also elsewhere on the board
ADC_CS: U3.B16 (IO_L29N_A22_M1A14_1); also elsewhere on the board
ADC_DIN: U3.B15 (IO_L29P_A23_M1A13_1); also elsewhere on the board
ADC_DOUT: U3.D14 (IO_L31P_A19_M1CKE_1); also elsewhere on the board
ADC_SCLK: U3.E12 (IO_L1N_A24_VREF_1); also elsewhere on the board
GND: C6.1, C7.1, C8.1, C9.1, C10.1, C11.1, C12.1, C13.2, C14.2, R2.2, U3.C4 (IO_L1P_HSWAPEN_0), U4.2 (GND); also elsewhere on the board
IMU_CS: U3.D16 (IO_L31N_A18_M1A12_1); also elsewhere on the board
IMU_INT1: U3.G14 (IO_L36P_A9_M1BA0_1); also elsewhere on the board
IMU_INT2: U3.C16 (IO_L33N_A14_M1A4_1); also elsewhere on the board
IMU_SCL_SPC: U3.E16 (IO_L34N_A12_M1BA2_1); also elsewhere on the board
IMU_SDA_SDI_SDO: U3.F15 (IO_L35P_A11_M1A7_1); also elsewhere on the board
IMU_SDO_SAO: U3.G16 (IO_L36N_A8_M1BA1_1); also elsewhere on the board
IO_A02: U3.N14 (IO_L45P_A1_M1LDQS_1); also elsewhere on the board
IO_A03: U3.M13 (IO_L74P_AWAKE_1); also elsewhere on the board
IO_B07: U3.J13 (IO_L41P_GCLK9_IRDY1_M1RASN_1); also elsewhere on the board
IO_C01: U3.D11 (IO_L66P_SCP1_0); also elsewhere on the board
IO_C02: U3.C13 (IO_L63P_SCP7_0); also elsewhere on the board
IO_C03: U3.B14 (IO_L65P_SCP3_0); also elsewhere on the board
IO_C04: U3.C15 (IO_L33P_A15_M1A10_1); also elsewhere on the board
IO_C05: U3.A13 (IO_L63N_SCP6_0); also elsewhere on the board
IO_C06: U3.A14 (IO_L65N_SCP2_0); also elsewhere on the board
IO_C07: U3.A12 (IO_L62N_VREF_0); also elsewhere on the board
IO_D01: U3.B12 (IO_L62P_0); also elsewhere on the board
IO_D02: U3.A11 (IO_L39N_0); also elsewhere on the board
IO_D03: U3.C11 (IO_L39P_0); also elsewhere on the board
IO_D04: U3.A10 (IO_L35N_GCLK16_0); also elsewhere on the board
IO_D05: U3.B10 (IO_L35P_GCLK17_0); also elsewhere on the board
IO_D06: U3.A8 (IO_L33N_0); also elsewhere on the board
IO_D07: U3.A9 (IO_L34N_GCLK18_0); also elsewhere on the board
IO_E01: U3.A7 (IO_L6N_0); also elsewhere on the board
IO_E02: U3.B8 (IO_L33P_0); also elsewhere on the board
IO_E03: U3.D9 (IO_L40N_0); also elsewhere on the board
IO_E04: U3.A6 (IO_L4N_0); also elsewhere on the board
IO_E05: U3.D8 (IO_L38P_0); also elsewhere on the board
IO_E06: U3.C8 (IO_L38N_VREF_0); also elsewhere on the board
IO_E07: U3.E6 (IO_L5N_0); also elsewhere on the board
IO_F01: U3.C6 (IO_L7N_0); also elsewhere on the board
IO_F02: U3.D6 (IO_L7P_0); also elsewhere on the board
IO_F03: U3.C5 (IO_L3N_0); also elsewhere on the board
IO_F04: U3.B6 (IO_L4P_0); also elsewhere on the board
IO_F05: U3.D5 (IO_L3P_0); also elsewhere on the board
IO_F06: U3.A4 (IO_L1N_VREF_0); also elsewhere on the board
IO_F07: U3.A5 (IO_L2N_0); also elsewhere on the board
unnamed: R2.1, R3.2, SW1.2
OSC_OUT: U3.C9 (IO_L34P_GCLK19_0), U4.3 (OUT)
RAM_A8: U3.B5 (IO_L2P_0); also elsewhere on the board
XC_P12: U3.R12 (IO_L52P_M1DQ14_1); also elsewhere on the board
XC_R11: U3.T13 (IO_L51N_M1DQ13_1); also elsewhere on the board
XC_RST: C14.1, R3.1; also elsewhere on the board
XC_T10: U3.T12 (IO_L52N_M1DQ15_1); also elsewhere on the board

Notes on the sheet:
OSCILADOR
SYSTEM RESET

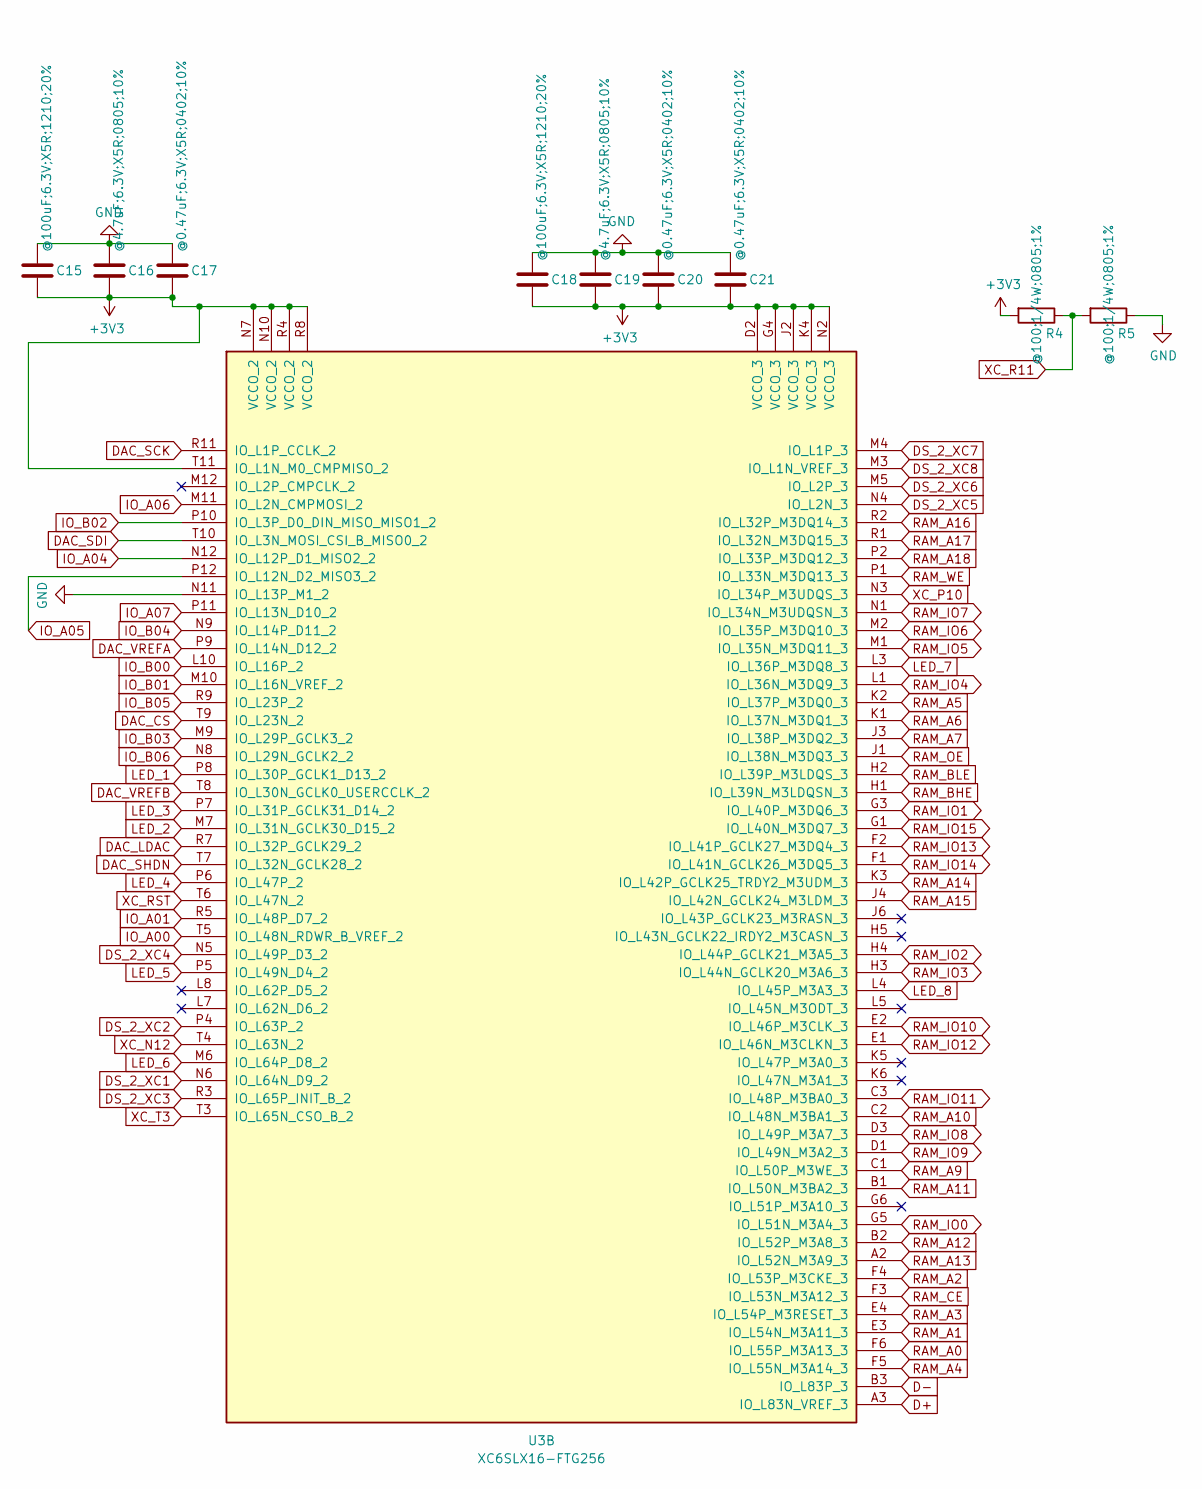
[picture p9: schematic FPGA_PartB.sch, Spartan6 FTG256 Part B]

Parts:
C15, C18: @100uF;6.3V;X5R;1210;20%; C_1210_3225Metric_Pad1.33x2.70mm_HandSolder
C16, C19: @4.7uF;6.3V;X5R;0805;10%; C_0805_2012Metric_Pad1.18x1.45mm_HandSolder
C17, C20, C21: @0.47uF;6.3V;X5R;0402;10%; C_0402_1005Metric_Pad0.74x0.62mm_HandSolder
R4, R5: @100;1/4W;0805;1%; R_0805_2012Metric_Pad1.20x1.40mm_HandSolder
U3: XC6SLX16-FTG256; BGA-256_17.0x17.0mm_Layout16x16_P1.0mm_Ball0.5mm_Pad0.4mm_N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

Connections:
+3V3: C15.2, C16.2, C17.2, C18.2, C19.2, C20.2, C21.2, R4.2, U3.D2 (VCCO_3), U3.G4 (VCCO_3), U3.J2 (VCCO_3), U3.K4 (VCCO_3), U3.N2 (VCCO_3), U3.N7 (VCCO_2), U3.N10 (VCCO_2), U3.R4 (VCCO_2), U3.R8 (VCCO_2), U3.T11 (IO_L1N_M0_CMPMISO_2); also elsewhere on the board
D+: U3.A3 (IO_L83N_VREF_3); also elsewhere on the board
D-: U3.B3 (IO_L83P_3); also elsewhere on the board
DAC_CS: U3.T9 (IO_L23N_2); also elsewhere on the board
DAC_LDAC: U3.R7 (IO_L32P_GCLK29_2); also elsewhere on the board
DAC_SCK: U3.R11 (IO_L1P_CCLK_2); also elsewhere on the board
DAC_SDI: U3.T10 (IO_L3N_MOSI_CSI_B_MISO0_2); also elsewhere on the board
DAC_SHDN: U3.T7 (IO_L32N_GCLK28_2); also elsewhere on the board
DAC_VREFA: U3.P9 (IO_L14N_D12_2); also elsewhere on the board
DAC_VREFB: U3.T8 (IO_L30N_GCLK0_USERCCLK_2); also elsewhere on the board
DS_2_XC1: U3.N6 (IO_L64N_D9_2); also elsewhere on the board
DS_2_XC2: U3.P4 (IO_L63P_2); also elsewhere on the board
DS_2_XC3: U3.R3 (IO_L65P_INIT_B_2); also elsewhere on the board
DS_2_XC4: U3.N5 (IO_L49P_D3_2); also elsewhere on the board
DS_2_XC5: U3.N4 (IO_L2N_3); also elsewhere on the board
DS_2_XC6: U3.M5 (IO_L2P_3); also elsewhere on the board
DS_2_XC7: U3.M4 (IO_L1P_3); also elsewhere on the board
DS_2_XC8: U3.M3 (IO_L1N_VREF_3); also elsewhere on the board
GND: C15.1, C16.1, C17.1, C18.1, C19.1, C20.1, C21.1, R5.1, U3.N11 (IO_L13P_M1_2); also elsewhere on the board
IO_A00: U3.T5 (IO_L48N_RDWR_B_VREF_2); also elsewhere on the board
IO_A01: U3.R5 (IO_L48P_D7_2); also elsewhere on the board
IO_A04: U3.N12 (IO_L12P_D1_MISO2_2); also elsewhere on the board
IO_A05: U3.P12 (IO_L12N_D2_MISO3_2); also elsewhere on the board
IO_A06: U3.M11 (IO_L2N_CMPMOSI_2); also elsewhere on the board
IO_A07: U3.P11 (IO_L13N_D10_2); also elsewhere on the board
IO_B00: U3.L10 (IO_L16P_2); also elsewhere on the board
IO_B01: U3.M10 (IO_L16N_VREF_2); also elsewhere on the board
IO_B02: U3.P10 (IO_L3P_D0_DIN_MISO_MISO1_2); also elsewhere on the board
IO_B03: U3.M9 (IO_L29P_GCLK3_2); also elsewhere on the board
IO_B04: U3.N9 (IO_L14P_D11_2); also elsewhere on the board
IO_B05: U3.R9 (IO_L23P_2); also elsewhere on the board
IO_B06: U3.N8 (IO_L29N_GCLK2_2); also elsewhere on the board
LED_1: U3.P8 (IO_L30P_GCLK1_D13_2); also elsewhere on the board
LED_2: U3.M7 (IO_L31N_GCLK30_D15_2); also elsewhere on the board
LED_3: U3.P7 (IO_L31P_GCLK31_D14_2); also elsewhere on the board
LED_4: U3.P6 (IO_L47P_2); also elsewhere on the board
LED_5: U3.P5 (IO_L49N_D4_2); also elsewhere on the board
LED_6: U3.M6 (IO_L64P_D8_2); also elsewhere on the board
LED_7: U3.L3 (IO_L36P_M3DQ8_3); also elsewhere on the board
LED_8: U3.L4 (IO_L45P_M3A3_3); also elsewhere on the board
RAM_A0: U3.F6 (IO_L55P_M3A13_3); also elsewhere on the board
RAM_A1: U3.E3 (IO_L54N_M3A11_3); also elsewhere on the board
RAM_A2: U3.F4 (IO_L53P_M3CKE_3); also elsewhere on the board
RAM_A3: U3.E4 (IO_L54P_M3RESET_3); also elsewhere on the board
RAM_A4: U3.F5 (IO_L55N_M3A14_3); also elsewhere on the board
RAM_A5: U3.K2 (IO_L37P_M3DQ0_3); also elsewhere on the board
RAM_A6: U3.K1 (IO_L37N_M3DQ1_3); also elsewhere on the board
RAM_A7: U3.J3 (IO_L38P_M3DQ2_3); also elsewhere on the board
RAM_A9: U3.C1 (IO_L50P_M3WE_3); also elsewhere on the board
RAM_A10: U3.C2 (IO_L48N_M3BA1_3); also elsewhere on the board
RAM_A11: U3.B1 (IO_L50N_M3BA2_3); also elsewhere on the board
RAM_A12: U3.B2 (IO_L52P_M3A8_3); also elsewhere on the board
RAM_A13: U3.A2 (IO_L52N_M3A9_3); also elsewhere on the board
RAM_A14: U3.K3 (IO_L42P_GCLK25_TRDY2_M3UDM_3); also elsewhere on the board
RAM_A15: U3.J4 (IO_L42N_GCLK24_M3LDM_3); also elsewhere on the board
RAM_A16: U3.R2 (IO_L32P_M3DQ14_3); also elsewhere on the board
RAM_A17: U3.R1 (IO_L32N_M3DQ15_3); also elsewhere on the board
RAM_A18: U3.P2 (IO_L33P_M3DQ12_3); also elsewhere on the board
RAM_BHE: U3.H1 (IO_L39N_M3LDQSN_3); also elsewhere on the board
RAM_BLE: U3.H2 (IO_L39P_M3LDQS_3); also elsewhere on the board
RAM_CE: U3.F3 (IO_L53N_M3A12_3); also elsewhere on the board
RAM_IO0: U3.G5 (IO_L51N_M3A4_3); also elsewhere on the board
RAM_IO1: U3.G3 (IO_L40P_M3DQ6_3); also elsewhere on the board
RAM_IO2: U3.H4 (IO_L44P_GCLK21_M3A5_3); also elsewhere on the board
RAM_IO3: U3.H3 (IO_L44N_GCLK20_M3A6_3); also elsewhere on the board
RAM_IO4: U3.L1 (IO_L36N_M3DQ9_3); also elsewhere on the board
RAM_IO5: U3.M1 (IO_L35N_M3DQ11_3); also elsewhere on the board
RAM_IO6: U3.M2 (IO_L35P_M3DQ10_3); also elsewhere on the board
RAM_IO7: U3.N1 (IO_L34N_M3UDQSN_3); also elsewhere on the board
RAM_IO8: U3.D3 (IO_L49P_M3A7_3); also elsewhere on the board
RAM_IO9: U3.D1 (IO_L49N_M3A2_3); also elsewhere on the board
RAM_IO10: U3.E2 (IO_L46P_M3CLK_3); also elsewhere on the board
RAM_IO11: U3.C3 (IO_L48P_M3BA0_3); also elsewhere on the board
RAM_IO12: U3.E1 (IO_L46N_M3CLKN_3); also elsewhere on the board
RAM_IO13: U3.F2 (IO_L41P_GCLK27_M3DQ4_3); also elsewhere on the board
RAM_IO14: U3.F1 (IO_L41N_GCLK26_M3DQ5_3); also elsewhere on the board
RAM_IO15: U3.G1 (IO_L40N_M3DQ7_3); also elsewhere on the board
RAM_OE: U3.J1 (IO_L38N_M3DQ3_3); also elsewhere on the board
RAM_WE: U3.P1 (IO_L33N_M3DQ13_3); also elsewhere on the board
XC_N12: U3.T4 (IO_L63N_2); also elsewhere on the board
XC_P10: U3.N3 (IO_L34P_M3UDQS_3); also elsewhere on the board
XC_R11: R4.1, R5.2; also elsewhere on the board
XC_RST: U3.T6 (IO_L47N_2); also elsewhere on the board
XC_T3: U3.T3 (IO_L65N_CSO_B_2); also elsewhere on the board

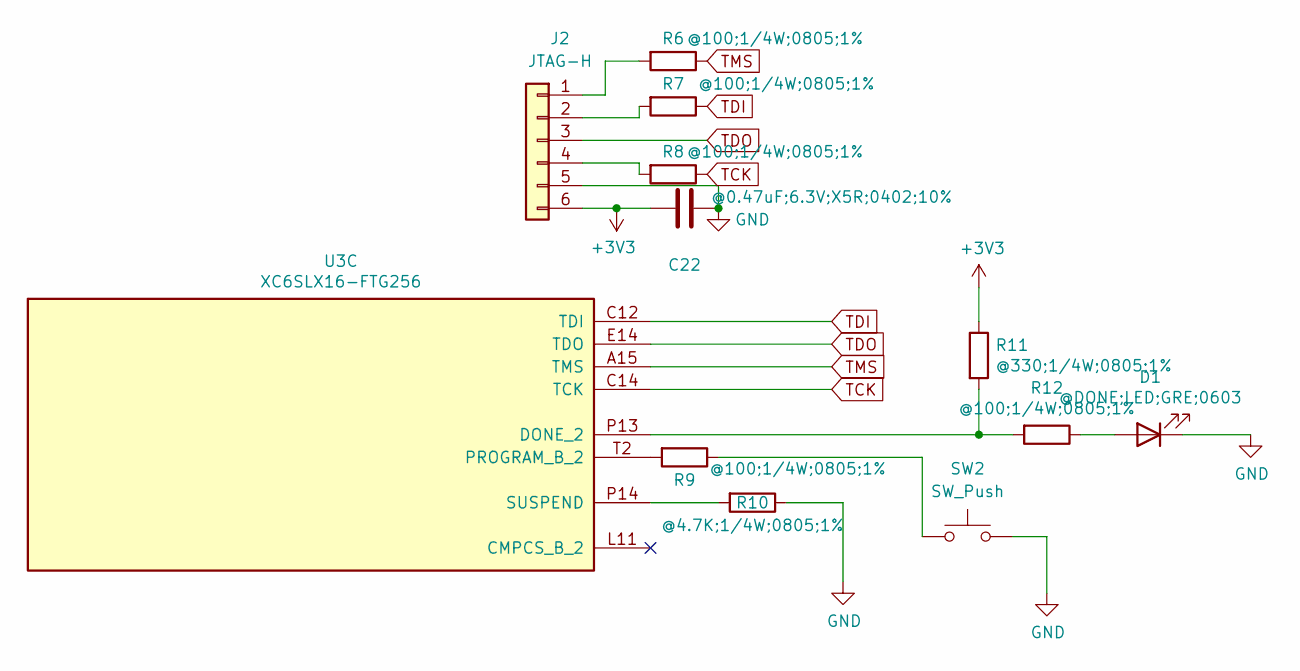
[picture p10: schematic FPGA_PartC.sch, Spartan6 FTG256 Part C]

Parts:
C22: @0.47uF;6.3V;X5R;0402;10%; C_0402_1005Metric_Pad0.74x0.62mm_HandSolder
D1: @DONE;LED;GRE;0603; LED_0603_1608Metric_Pad1.05x0.95mm_HandSolder
J2: JTAG-H; PinSocket_1x06_P2.54mm_Vertical
R6, R7, R8, R9, R12: @100;1/4W;0805;1%; R_0805_2012Metric_Pad1.20x1.40mm_HandSolder
R10: @4.7K;1/4W;0805;1%; R_0805_2012Metric_Pad1.20x1.40mm_HandSolder
R11: @330;1/4W;0805;1%; R_0805_2012Metric_Pad1.20x1.40mm_HandSolder
SW2: SW_Push; SW_Push_1P1T_NO_6x6mm_H9.5mm
U3: XC6SLX16-FTG256; BGA-256_17.0x17.0mm_Layout16x16_P1.0mm_Ball0.5mm_Pad0.4mm_N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

Connections:
+3V3: C22.2, J2.6, R11.1; also elsewhere on the board
GND: C22.1, D1.1 (K), J2.5, R10.1, SW2.2; also elsewhere on the board
unnamed: D1.2 (A), R12.1
unnamed: J2.1, R6.2
unnamed: J2.2, R7.2
unnamed: J2.4, R8.2
unnamed: R9.1, SW2.1
unnamed: R9.2, U3.T2 (PROGRAM_B_2)
unnamed: R10.2, U3.P14 (SUSPEND)
unnamed: R11.2, R12.2, U3.P13 (DONE_2)
TCK: R8.1, U3.C14 (TCK)
TDI: R7.1, U3.C12 (TDI)
TDO: J2.3, U3.E14 (TDO)
TMS: R6.1, U3.A15 (TMS)

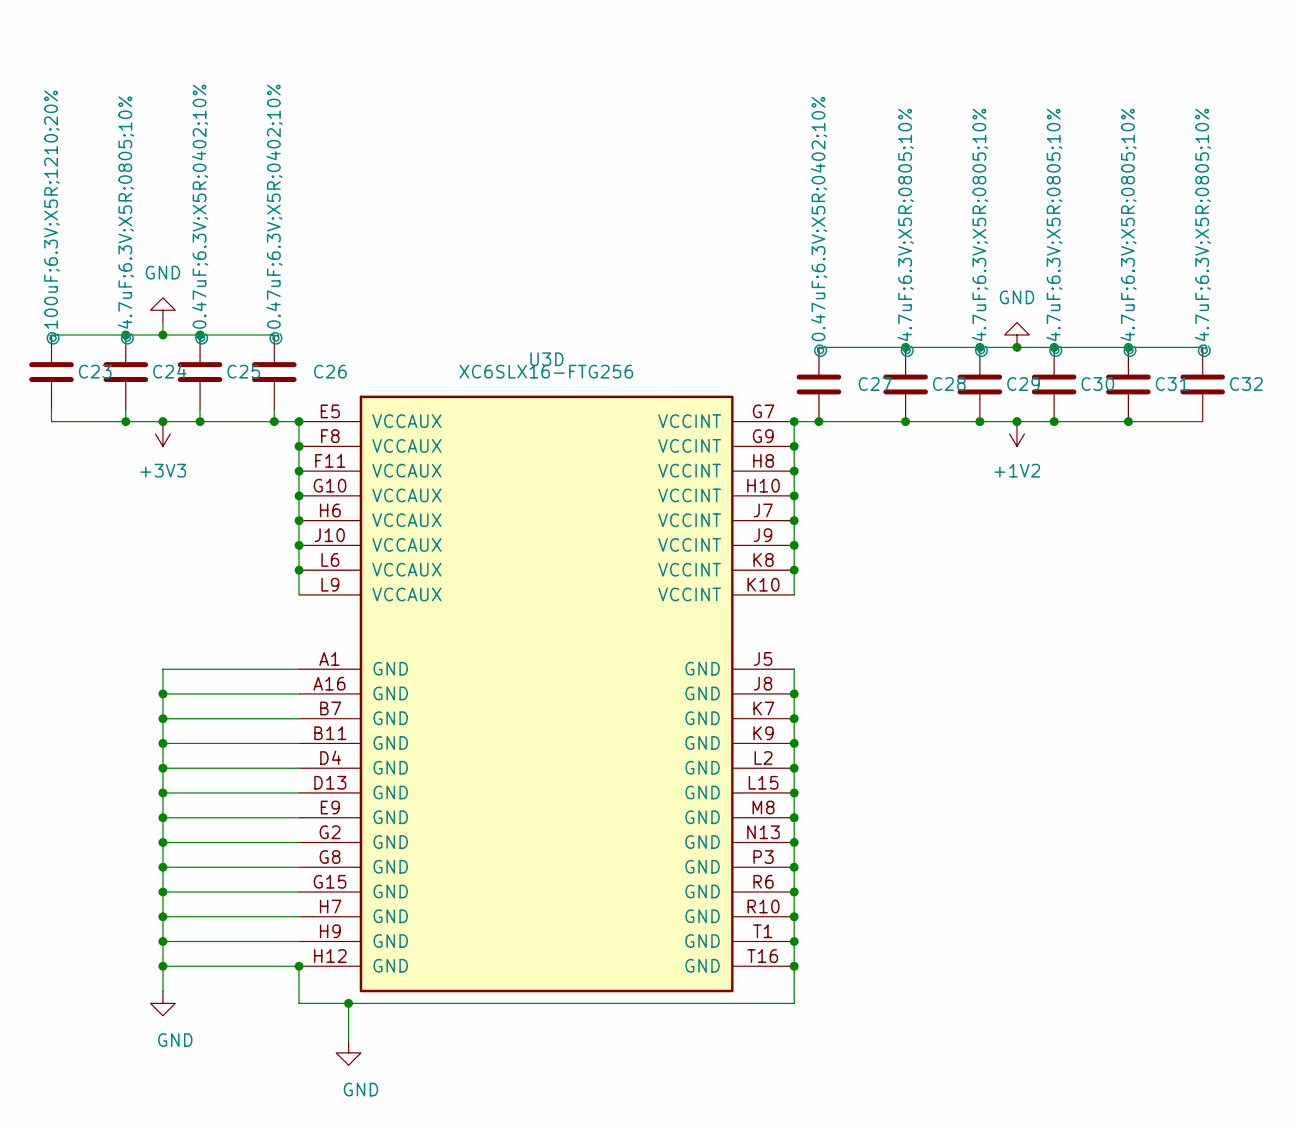
[picture p11: schematic FPGA_PartD.sch, Spartan6 FTG256 Part D]

Parts:
C23: @100uF;6.3V;X5R;1210;20%; C_1210_3225Metric_Pad1.33x2.70mm_HandSolder
C24, C28, C29, C30, C31, C32: @4.7uF;6.3V;X5R;0805;10%; C_0805_2012Metric_Pad1.18x1.45mm_HandSolder
C25, C26, C27: @0.47uF;6.3V;X5R;0402;10%; C_0402_1005Metric_Pad0.74x0.62mm_HandSolder
U3: XC6SLX16-FTG256; BGA-256_17.0x17.0mm_Layout16x16_P1.0mm_Ball0.5mm_Pad0.4mm_N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

Connections:
+1V2: C27.2, C28.2, C29.2, C30.2, C31.2, C32.2, U3.G7 (VCCINT), U3.G9 (VCCINT), U3.H8 (VCCINT), U3.H10 (VCCINT), U3.J7 (VCCINT), U3.J9 (VCCINT), U3.K8 (VCCINT), U3.K10 (VCCINT); also elsewhere on the board
+3V3: C23.2, C24.2, C25.2, C26.2, U3.E5 (VCCAUX), U3.F8 (VCCAUX), U3.F11 (VCCAUX), U3.G10 (VCCAUX), U3.H6 (VCCAUX), U3.J10 (VCCAUX), U3.L6 (VCCAUX), U3.L9 (VCCAUX); also elsewhere on the board
GND: C23.1, C24.1, C25.1, C26.1, C27.1, C28.1, C29.1, C30.1, C31.1, C32.1, U3.A1 (GND), U3.A16 (GND), U3.B7 (GND), U3.B11 (GND), U3.D4 (GND), U3.D13 (GND), U3.E9 (GND), U3.G2 (GND), U3.G8 (GND), U3.G15 (GND), U3.H7 (GND), U3.H9 (GND), U3.H12 (GND), U3.J5 (GND), U3.J8 (GND), U3.K7 (GND), U3.K9 (GND), U3.L2 (GND), U3.L15 (GND), U3.M8 (GND), U3.N13 (GND), U3.P3 (GND), U3.R6 (GND), U3.R10 (GND), U3.T1 (GND), U3.T16 (GND); also elsewhere on the board

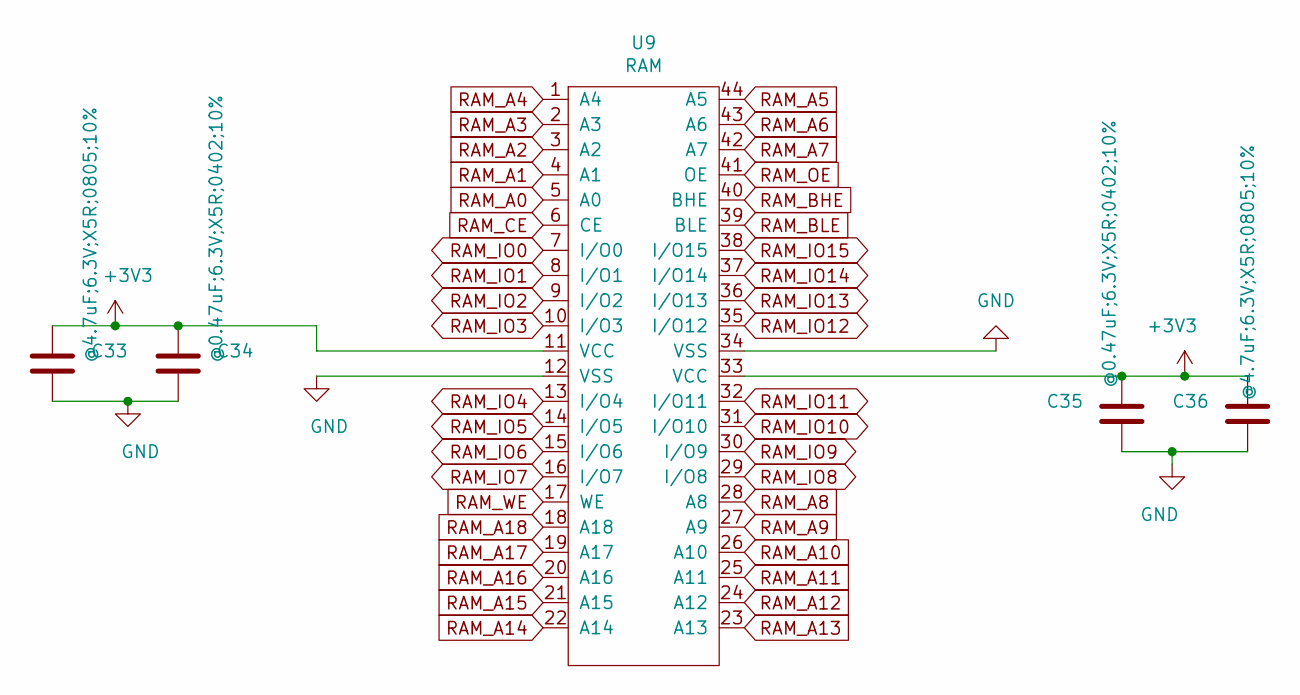
[picture p12: schematic RAM_Memory.sch, RAM]

Parts:
C33, C36: @4.7uF;6.3V;X5R;0805;10%; C_0805_2012Metric_Pad1.18x1.45mm_HandSolder
C34, C35: @0.47uF;6.3V;X5R;0402;10%; C_0402_1005Metric_Pad0.74x0.62mm_HandSolder
U9: RAM; SOP80P1176X120-44N

Connections:
+3V3: C33.1, C34.1, C35.1, C36.1, U9.11 (VCC), U9.33 (VCC); also elsewhere on the board
GND: C33.2, C34.2, C35.2, C36.2, U9.12 (VSS), U9.34 (VSS); also elsewhere on the board
RAM_A0: U9.5 (A0); also elsewhere on the board
RAM_A1: U9.4 (A1); also elsewhere on the board
RAM_A2: U9.3 (A2); also elsewhere on the board
RAM_A3: U9.2 (A3); also elsewhere on the board
RAM_A4: U9.1 (A4); also elsewhere on the board
RAM_A5: U9.44 (A5); also elsewhere on the board
RAM_A6: U9.43 (A6); also elsewhere on the board
RAM_A7: U9.42 (A7); also elsewhere on the board
RAM_A8: U9.28 (A8); also elsewhere on the board
RAM_A9: U9.27 (A9); also elsewhere on the board
RAM_A10: U9.26 (A10); also elsewhere on the board
RAM_A11: U9.25 (A11); also elsewhere on the board
RAM_A12: U9.24 (A12); also elsewhere on the board
RAM_A13: U9.23 (A13); also elsewhere on the board
RAM_A14: U9.22 (A14); also elsewhere on the board
RAM_A15: U9.21 (A15); also elsewhere on the board
RAM_A16: U9.20 (A16); also elsewhere on the board
RAM_A17: U9.19 (A17); also elsewhere on the board
RAM_A18: U9.18 (A18); also elsewhere on the board
RAM_BHE: U9.40 (BHE); also elsewhere on the board
RAM_BLE: U9.39 (BLE); also elsewhere on the board
RAM_CE: U9.6 (CE); also elsewhere on the board
RAM_IO0: U9.7 (I/O0); also elsewhere on the board
RAM_IO1: U9.8 (I/O1); also elsewhere on the board
RAM_IO2: U9.9 (I/O2); also elsewhere on the board
RAM_IO3: U9.10 (I/O3); also elsewhere on the board
RAM_IO4: U9.13 (I/O4); also elsewhere on the board
RAM_IO5: U9.14 (I/O5); also elsewhere on the board
RAM_IO6: U9.15 (I/O6); also elsewhere on the board
RAM_IO7: U9.16 (I/O7); also elsewhere on the board
RAM_IO8: U9.29 (I/O8); also elsewhere on the board
RAM_IO9: U9.30 (I/O9); also elsewhere on the board
RAM_IO10: U9.31 (I/O10); also elsewhere on the board
RAM_IO11: U9.32 (I/O11); also elsewhere on the board
RAM_IO12: U9.35 (I/O12); also elsewhere on the board
RAM_IO13: U9.36 (I/O13); also elsewhere on the board
RAM_IO14: U9.37 (I/O14); also elsewhere on the board
RAM_IO15: U9.38 (I/O15); also elsewhere on the board
RAM_OE: U9.41 (OE); also elsewhere on the board
RAM_WE: U9.17 (WE); also elsewhere on the board

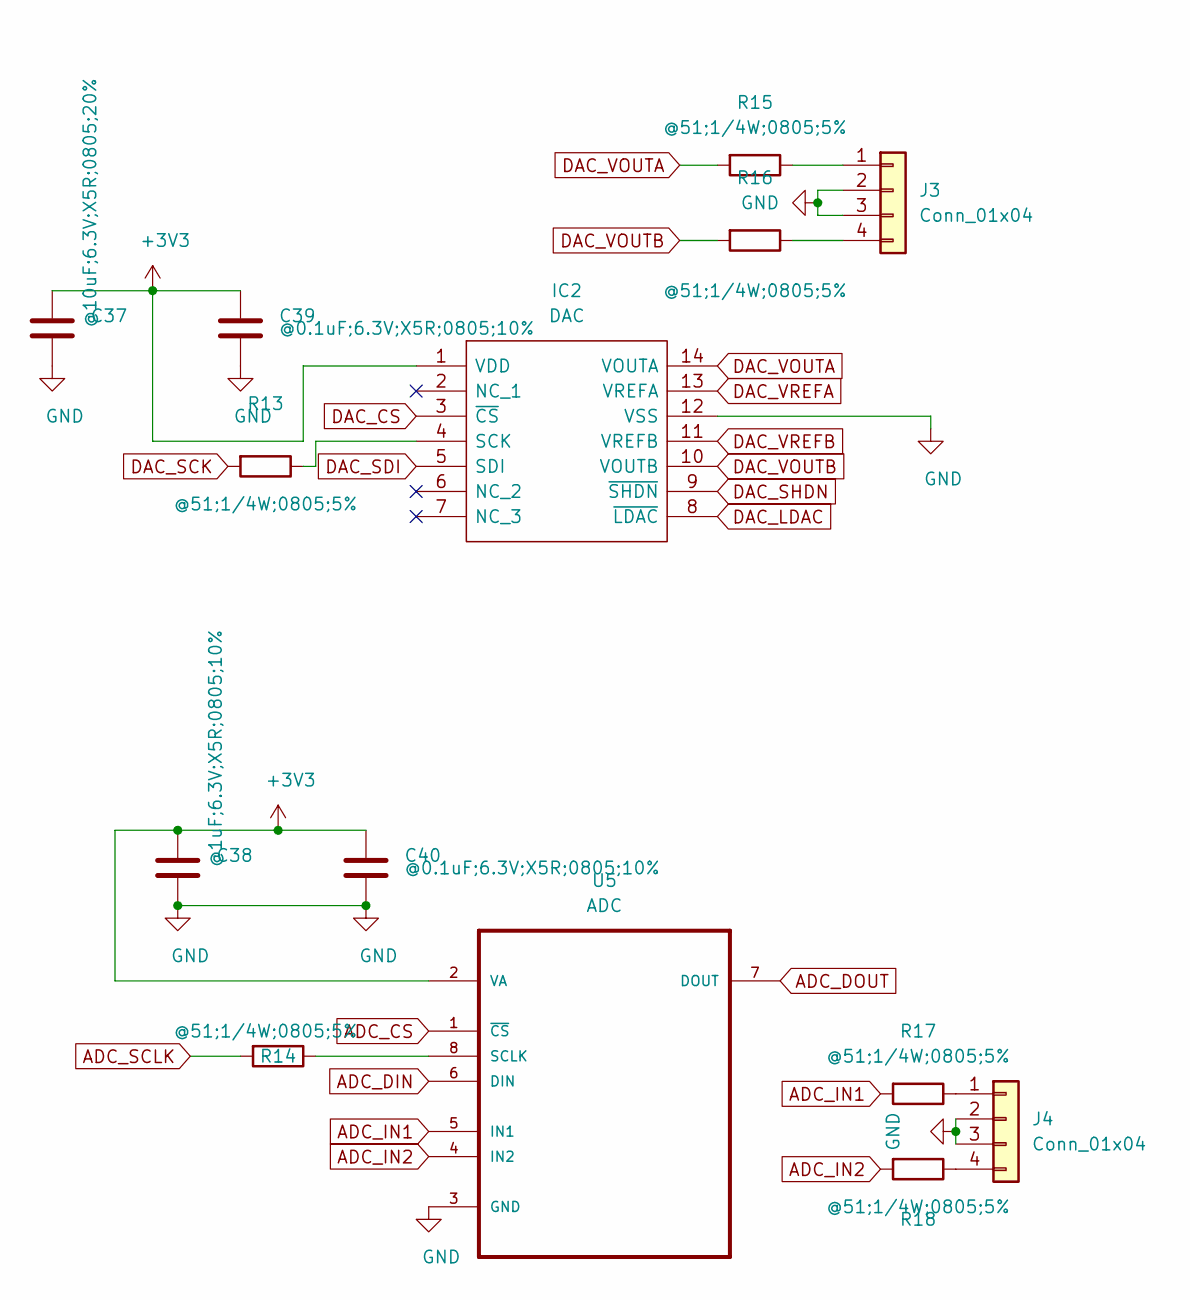
[picture p13: schematic ADC_DAC.sch, ADC snd DAC]

Parts:
C37: @10uF;6.3V;X5R;0805;20%; C_0805_2012Metric_Pad1.18x1.45mm_HandSolder
C38: @1uF;6.3V;X5R;0805;10%; C_0805_2012Metric_Pad1.18x1.45mm_HandSolder
C39, C40: @0.1uF;6.3V;X5R;0805;10%; C_0805_2012Metric_Pad1.18x1.45mm_HandSolder
IC2: DAC; SOP65P640X120-14N; Manufacturer_Part_Number MCP4922T-E/ST; Mouser Part Number 579-MCP4922T-E/ST
J3, J4: Conn_01x04; PinSocket_1x04_P2.54mm_Vertical
R13, R14, R15, R16, R17, R18: @51;1/4W;0805;5%; R_0805_2012Metric_Pad1.20x1.40mm_HandSolder
U5: ADC; SOP65P490X109-8N

Connections:
+3V3: C37.1, C38.1, C39.1, C40.1, IC2.1 (VDD), U5.2 (VA); also elsewhere on the board
ADC_CS: U5.1 (~CS); also elsewhere on the board
ADC_DIN: U5.6 (DIN); also elsewhere on the board
ADC_DOUT: U5.7 (DOUT); also elsewhere on the board
ADC_IN1: R17.2, U5.5 (IN1)
ADC_IN2: R18.2, U5.4 (IN2)
ADC_SCLK: R14.2; also elsewhere on the board
DAC_CS: IC2.3 (~CS); also elsewhere on the board
DAC_LDAC: IC2.8 (~LDAC); also elsewhere on the board
DAC_SCK: R13.2; also elsewhere on the board
DAC_SDI: IC2.5 (SDI); also elsewhere on the board
DAC_SHDN: IC2.9 (~SHDN); also elsewhere on the board
DAC_VOUTA: IC2.14 (VOUTA), R15.2
DAC_VOUTB: IC2.10 (VOUTB), R16.2
DAC_VREFA: IC2.13 (VREFA); also elsewhere on the board
DAC_VREFB: IC2.11 (VREFB); also elsewhere on the board
GND: C37.2, C38.2, C39.2, C40.2, IC2.12 (VSS), J3.2, J3.3, J4.2, J4.3, U5.3 (GND); also elsewhere on the board
unnamed: IC2.4 (SCK), R13.1
unnamed: J3.1, R15.1
unnamed: J3.4, R16.1
unnamed: J4.1, R17.1
unnamed: J4.4, R18.1
unnamed: R14.1, U5.8 (SCLK)

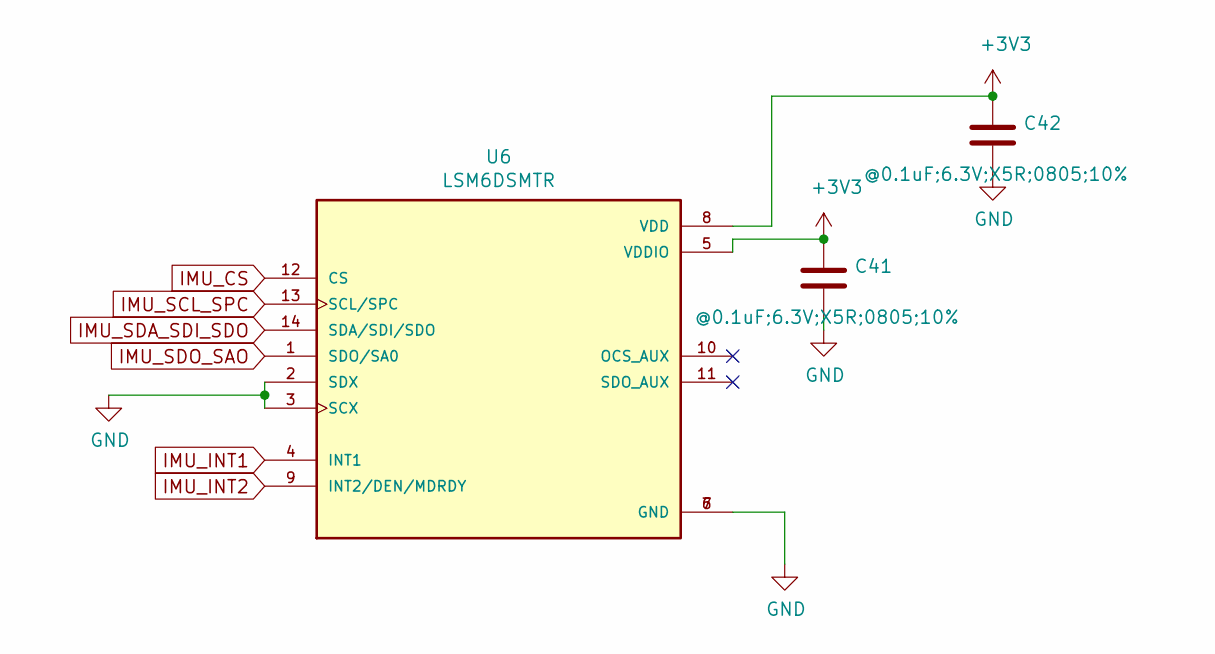
[picture p14: schematic IMU.sch]

Parts:
C41, C42: @0.1uF;6.3V;X5R;0805;10%; C_0805_2012Metric_Pad1.18x1.45mm_HandSolder
U6: LSM6DSMTR; PQFN50P300X250X86-14N; PARTREV Rev 7

Connections:
+3V3: C41.1, C42.1, U6.5 (VDDIO), U6.8 (VDD); also elsewhere on the board
GND: C41.2, C42.2, U6.2 (SDX), U6.3 (SCX), U6.6 (GND), U6.7 (GND); also elsewhere on the board
IMU_CS: U6.12 (CS); also elsewhere on the board
IMU_INT1: U6.4 (INT1); also elsewhere on the board
IMU_INT2: U6.9 (INT2/DEN/MDRDY); also elsewhere on the board
IMU_SCL_SPC: U6.13 (SCL/SPC); also elsewhere on the board
IMU_SDA_SDI_SDO: U6.14 (SDA/SDI/SDO); also elsewhere on the board
IMU_SDO_SAO: U6.1 (SDO/SA0); also elsewhere on the board
