galan-e/Tarjeta_v02/KiCad-project/obi1/obi1.kicad_pcb

## KiCad design KiCad-project/obi1/obi1.kicad_pcb (continued)

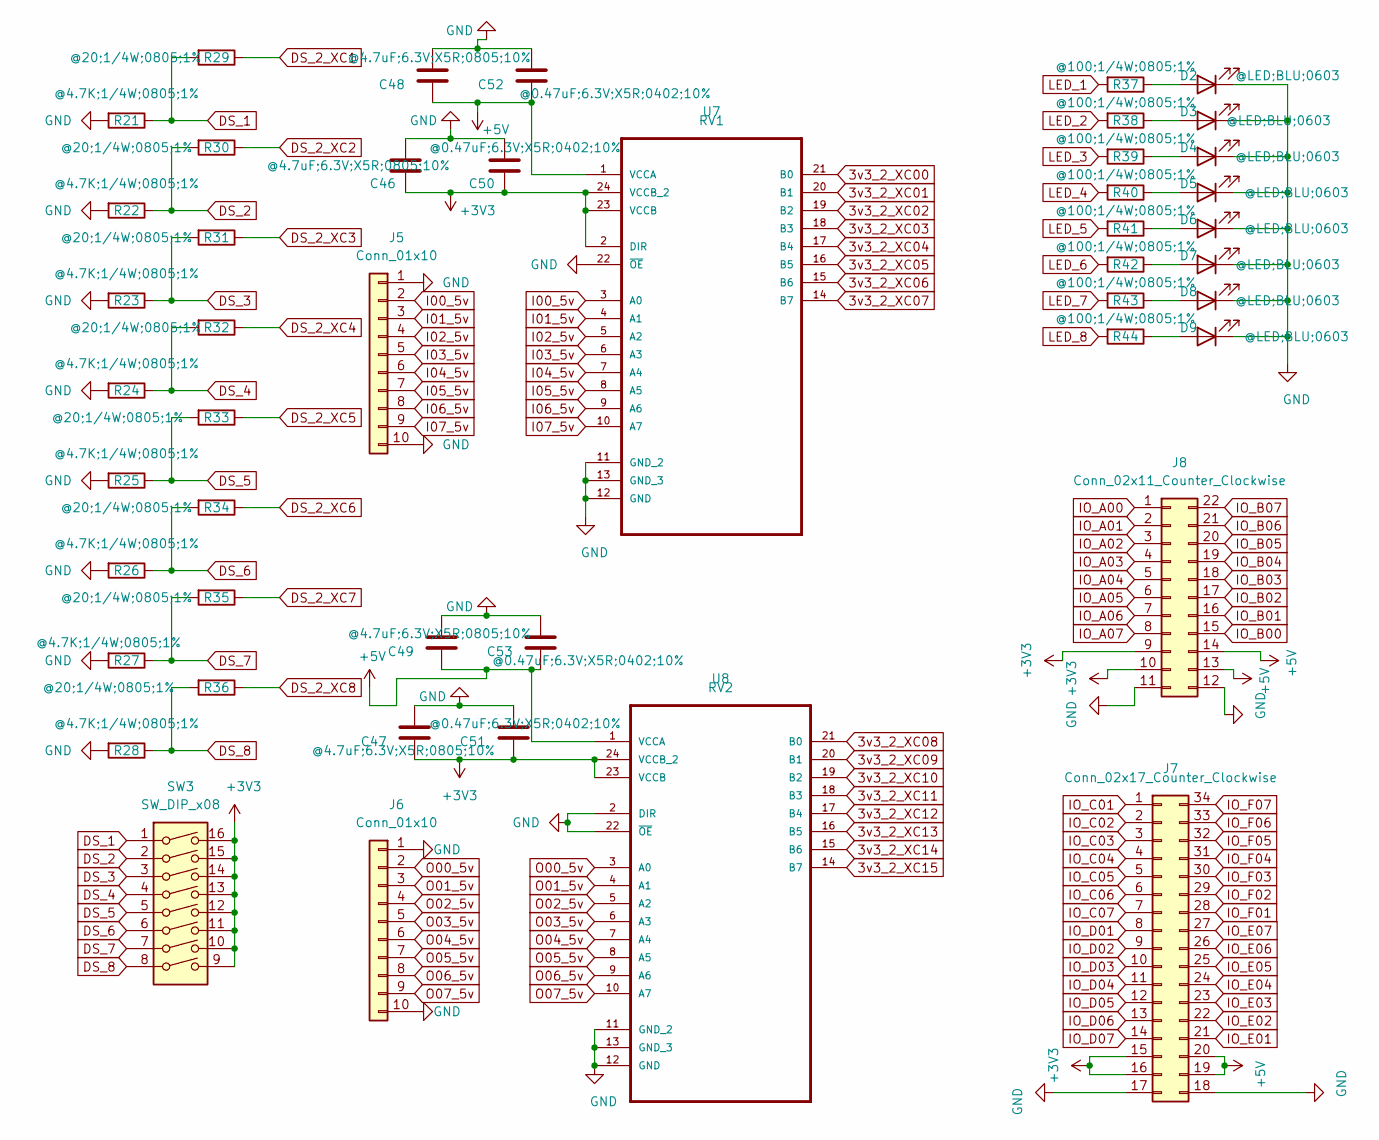
[picture p15: schematic Inputs_Outputs.sch, Inputs and Outputs]

Parts:
C46, C47, C48, C49: @4.7uF;6.3V;X5R;0805;10%; C_0805_2012Metric_Pad1.18x1.45mm_HandSolder
C50, C51, C52, C53: @0.47uF;6.3V;X5R;0402;10%; C_0402_1005Metric_Pad0.74x0.62mm_HandSolder
D2, D3, D4, D5, D6, D7, D8, D9: @LED;BLU;0603; LED_0603_1608Metric_Pad1.05x0.95mm_HandSolder
J5, J6: Conn_01x10; PinSocket_1x10_P2.54mm_Vertical
J7: Conn_02x17_Counter_Clockwise; PinSocket_2x17_P2.54mm_Vertical
J8: Conn_02x11_Counter_Clockwise; PinSocket_2x11_P2.54mm_Vertical
R21, R22, R23, R24, R25, R26, R27, R28: @4.7K;1/4W;0805;1%; R_0805_2012Metric_Pad1.20x1.40mm_HandSolder
R29, R30, R31, R32, R33, R34, R35, R36: @20;1/4W;0805;1%; R_0805_2012Metric_Pad1.20x1.40mm_HandSolder
R37, R38, R39, R40, R41, R42, R43, R44: @100;1/4W;0805;1%; R_0805_2012Metric_Pad1.20x1.40mm_HandSolder
SW3: SW_DIP_x08; SW_DIP_SPSTx08_Slide_9.78x22.5mm_W7.62mm_P2.54mm
U7: RV1; SOP65P640X110-24N
U8: RV2; SOP65P640X110-24N

Connections:
3v3_2_XC00: U7.21 (B0); also elsewhere on the board
3v3_2_XC01: U7.20 (B1); also elsewhere on the board
3v3_2_XC02: U7.19 (B2); also elsewhere on the board
3v3_2_XC03: U7.18 (B3); also elsewhere on the board
3v3_2_XC04: U7.17 (B4); also elsewhere on the board
3v3_2_XC05: U7.16 (B5); also elsewhere on the board
3v3_2_XC06: U7.15 (B6); also elsewhere on the board
3v3_2_XC07: U7.14 (B7); also elsewhere on the board
3v3_2_XC08: U8.21 (B0); also elsewhere on the board
3v3_2_XC09: U8.20 (B1); also elsewhere on the board
3v3_2_XC10: U8.19 (B2); also elsewhere on the board
3v3_2_XC11: U8.18 (B3); also elsewhere on the board
3v3_2_XC12: U8.17 (B4); also elsewhere on the board
3v3_2_XC13: U8.16 (B5); also elsewhere on the board
3v3_2_XC14: U8.15 (B6); also elsewhere on the board
3v3_2_XC15: U8.14 (B7); also elsewhere on the board
+3V3: C46.1, C47.1, C50.1, C51.1, J7.15, J7.16, J8.9, J8.10, SW3.9, SW3.10, SW3.11, SW3.12, SW3.13, SW3.14, SW3.15, SW3.16, U7.2 (DIR), U7.23 (VCCB), U7.24 (VCCB_2), U8.23 (VCCB), U8.24 (VCCB_2); also elsewhere on the board
+5V: C48.1, C49.1, C52.1, C53.1, J7.19, J7.20, J8.13, J8.14, U7.1 (VCCA), U8.1 (VCCA); also elsewhere on the board
DS_1: R21.1, R29.2, SW3.1
DS_2: R22.1, R30.2, SW3.2
DS_2_XC1: R29.1; also elsewhere on the board
DS_2_XC2: R30.1; also elsewhere on the board
DS_2_XC3: R31.1; also elsewhere on the board
DS_2_XC4: R32.1; also elsewhere on the board
DS_2_XC5: R33.1; also elsewhere on the board
DS_2_XC6: R34.1; also elsewhere on the board
DS_2_XC7: R35.1; also elsewhere on the board
DS_2_XC8: R36.1; also elsewhere on the board
DS_3: R23.1, R31.2, SW3.3
DS_4: R24.1, R32.2, SW3.4
DS_5: R25.1, R33.2, SW3.5
DS_6: R26.1, R34.2, SW3.6
DS_7: R27.1, R35.2, SW3.7
DS_8: R28.1, R36.2, SW3.8
GND: C46.2, C47.2, C48.2, C49.2, C50.2, C51.2, C52.2, C53.2, D2.1 (K), D3.1 (K), D4.1 (K), D5.1 (K), D6.1 (K), D7.1 (K), D8.1 (K), D9.1 (K), J5.1, J5.10, J6.1, J6.10, J7.17, J7.18, J8.11, J8.12, R21.2, R22.2, R23.2, R24.2, R25.2, R26.2, R27.2, R28.2, U7.11 (GND_2), U7.12 (GND), U7.13 (GND_3), U7.22 (~OE), U8.2 (DIR), U8.11 (GND_2), U8.12 (GND), U8.13 (GND_3), U8.22 (~OE); also elsewhere on the board
I00_5v: J5.2, U7.3 (A0)
I01_5v: J5.3, U7.4 (A1)
I02_5v: J5.4, U7.5 (A2)
I03_5v: J5.5, U7.6 (A3)
I04_5v: J5.6, U7.7 (A4)
I05_5v: J5.7, U7.8 (A5)
I06_5v: J5.8, U7.9 (A6)
I07_5v: J5.9, U7.10 (A7)
IO_A00: J8.1; also elsewhere on the board
IO_A01: J8.2; also elsewhere on the board
IO_A02: J8.3; also elsewhere on the board
IO_A03: J8.4; also elsewhere on the board
IO_A04: J8.5; also elsewhere on the board
IO_A05: J8.6; also elsewhere on the board
IO_A06: J8.7; also elsewhere on the board
IO_A07: J8.8; also elsewhere on the board
IO_B00: J8.15; also elsewhere on the board
IO_B01: J8.16; also elsewhere on the board
IO_B02: J8.17; also elsewhere on the board
IO_B03: J8.18; also elsewhere on the board
IO_B04: J8.19; also elsewhere on the board
IO_B05: J8.20; also elsewhere on the board
IO_B06: J8.21; also elsewhere on the board
IO_B07: J8.22; also elsewhere on the board
IO_C01: J7.1; also elsewhere on the board
IO_C02: J7.2; also elsewhere on the board
IO_C03: J7.3; also elsewhere on the board
IO_C04: J7.4; also elsewhere on the board
IO_C05: J7.5; also elsewhere on the board
IO_C06: J7.6; also elsewhere on the board
IO_C07: J7.7; also elsewhere on the board
IO_D01: J7.8; also elsewhere on the board
IO_D02: J7.9; also elsewhere on the board
IO_D03: J7.10; also elsewhere on the board
IO_D04: J7.11; also elsewhere on the board
IO_D05: J7.12; also elsewhere on the board
IO_D06: J7.13; also elsewhere on the board
IO_D07: J7.14; also elsewhere on the board
IO_E01: J7.21; also elsewhere on the board
IO_E02: J7.22; also elsewhere on the board
IO_E03: J7.23; also elsewhere on the board
IO_E04: J7.24; also elsewhere on the board
IO_E05: J7.25; also elsewhere on the board
IO_E06: J7.26; also elsewhere on the board
IO_E07: J7.27; also elsewhere on the board
IO_F01: J7.28; also elsewhere on the board
IO_F02: J7.29; also elsewhere on the board
IO_F03: J7.30; also elsewhere on the board
IO_F04: J7.31; also elsewhere on the board
IO_F05: J7.32; also elsewhere on the board
IO_F06: J7.33; also elsewhere on the board
IO_F07: J7.34; also elsewhere on the board
LED_1: R37.2; also elsewhere on the board
LED_2: R38.2; also elsewhere on the board
LED_3: R39.2; also elsewhere on the board
LED_4: R40.2; also elsewhere on the board
LED_5: R41.2; also elsewhere on the board
LED_6: R42.2; also elsewhere on the board
LED_7: R43.2; also elsewhere on the board
LED_8: R44.2; also elsewhere on the board
unnamed: D2.2 (A), R37.1
unnamed: D3.2 (A), R38.1
unnamed: D4.2 (A), R39.1
unnamed: D5.2 (A), R40.1
unnamed: D6.2 (A), R41.1
unnamed: D7.2 (A), R42.1
unnamed: D8.2 (A), R43.1
unnamed: D9.2 (A), R44.1
O00_5v: J6.2, U8.3 (A0)
O01_5v: J6.3, U8.4 (A1)
O02_5v: J6.4, U8.5 (A2)
O03_5v: J6.5, U8.6 (A3)
O04_5v: J6.6, U8.7 (A4)
O05_5v: J6.7, U8.8 (A5)
O06_5v: J6.8, U8.9 (A6)
O07_5v: J6.9, U8.10 (A7)

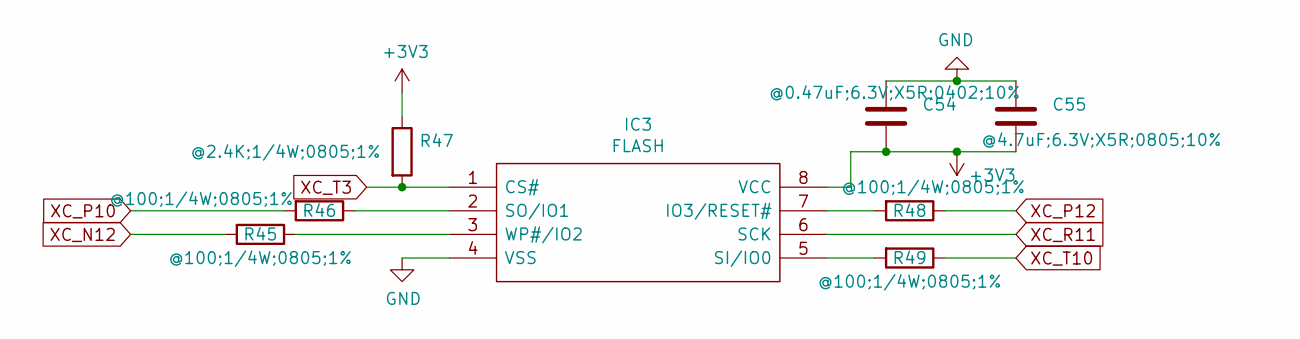
[picture p16: schematic Flash_Memory.sch, Flas memory]

Parts:
C54: @0.47uF;6.3V;X5R;0402;10%; C_0402_1005Metric_Pad0.74x0.62mm_HandSolder
C55: @4.7uF;6.3V;X5R;0805;10%; C_0805_2012Metric_Pad1.18x1.45mm_HandSolder
IC3: FLASH; SOIC127P800X216-8N; Manufacturer_Part_Number S25FL064LABMFI013; Mouser Part Number 727-S25FL064LAMFI013
R45, R46, R48, R49: @100;1/4W;0805;1%; R_0805_2012Metric_Pad1.20x1.40mm_HandSolder
R47: @2.4K;1/4W;0805;1%; R_0805_2012Metric_Pad1.20x1.40mm_HandSolder

Connections:
+3V3: C54.2, C55.2, IC3.8 (VCC), R47.1; also elsewhere on the board
GND: C54.1, C55.1, IC3.4 (VSS); also elsewhere on the board
unnamed: IC3.2 (SO/IO1), R46.1
unnamed: IC3.3 (WP#/IO2), R45.1
unnamed: IC3.5 (SI/IO0), R49.2
unnamed: IC3.7 (IO3/RESET#), R48.2
XC_N12: R45.2; also elsewhere on the board
XC_P10: R46.2; also elsewhere on the board
XC_P12: R48.1; also elsewhere on the board
XC_R11: IC3.6 (SCK); also elsewhere on the board
XC_T3: IC3.1 (CS#), R47.2; also elsewhere on the board
XC_T10: R49.1; also elsewhere on the board

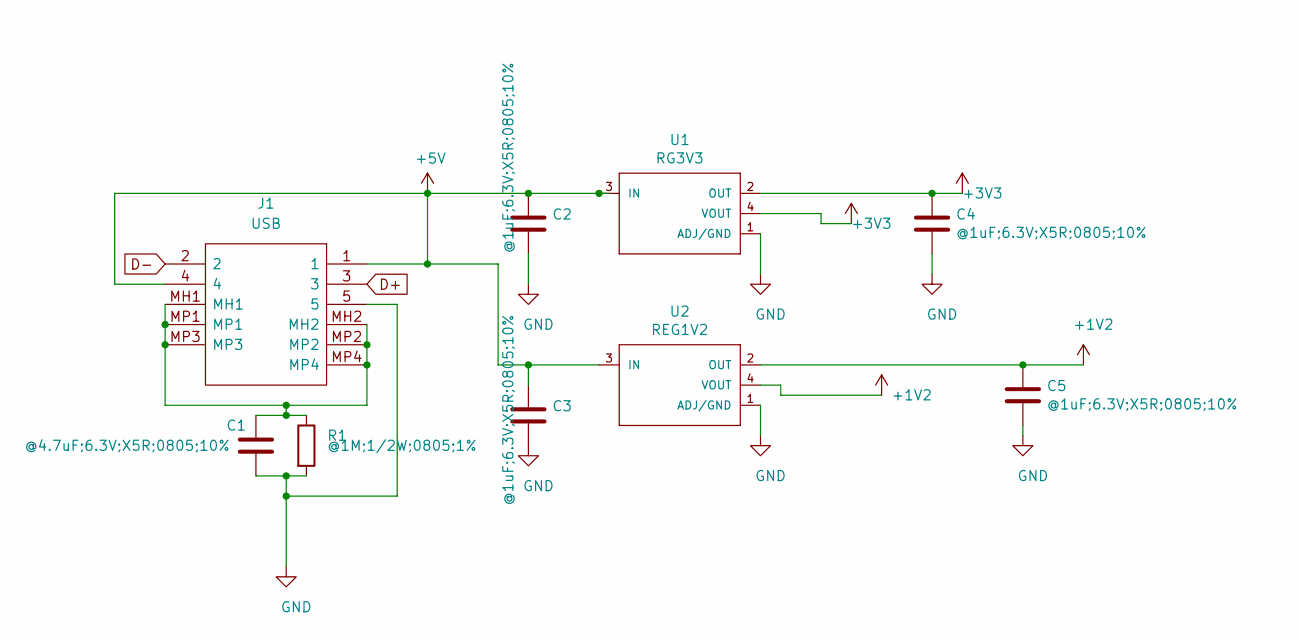
[picture p17: schematic POWER_SUPLY.sch, Power Suply]

Parts:
C1: @4.7uF;6.3V;X5R;0805;10%; C_0805_2012Metric_Pad1.18x1.45mm_HandSolder
C2, C3, C4, C5: @1uF;6.3V;X5R;0805;10%; C_0805_2012Metric_Pad1.18x1.45mm_HandSolder
J1: USB; 101181930001LF
R1: @1M;1/2W;0805;1%; R_0805_2012Metric_Pad1.20x1.40mm_HandSolder
U1: RG3V3; SOT230P700X180-4N3.3
U2: REG1V2; SOT230P700X180-4N1.2

Connections:
+1V2: C5.1, U2.2 (OUT), U2.4 (VOUT); also elsewhere on the board
+3V3: C4.1, U1.2 (OUT), U1.4 (VOUT); also elsewhere on the board
+5V: C2.1, C3.1, J1.1, J1.4, U1.3 (IN), U2.3 (IN); also elsewhere on the board
D+: J1.3; also elsewhere on the board
D-: J1.2; also elsewhere on the board
GND: C1.2, C2.2, C3.2, C4.2, C5.2, J1.5, R1.2, U1.1 (ADJ/GND), U2.1 (ADJ/GND); also elsewhere on the board
unnamed: C1.1, J1.MH1, J1.MH2, J1.MP1, J1.MP2, J1.MP3, J1.MP4, R1.1

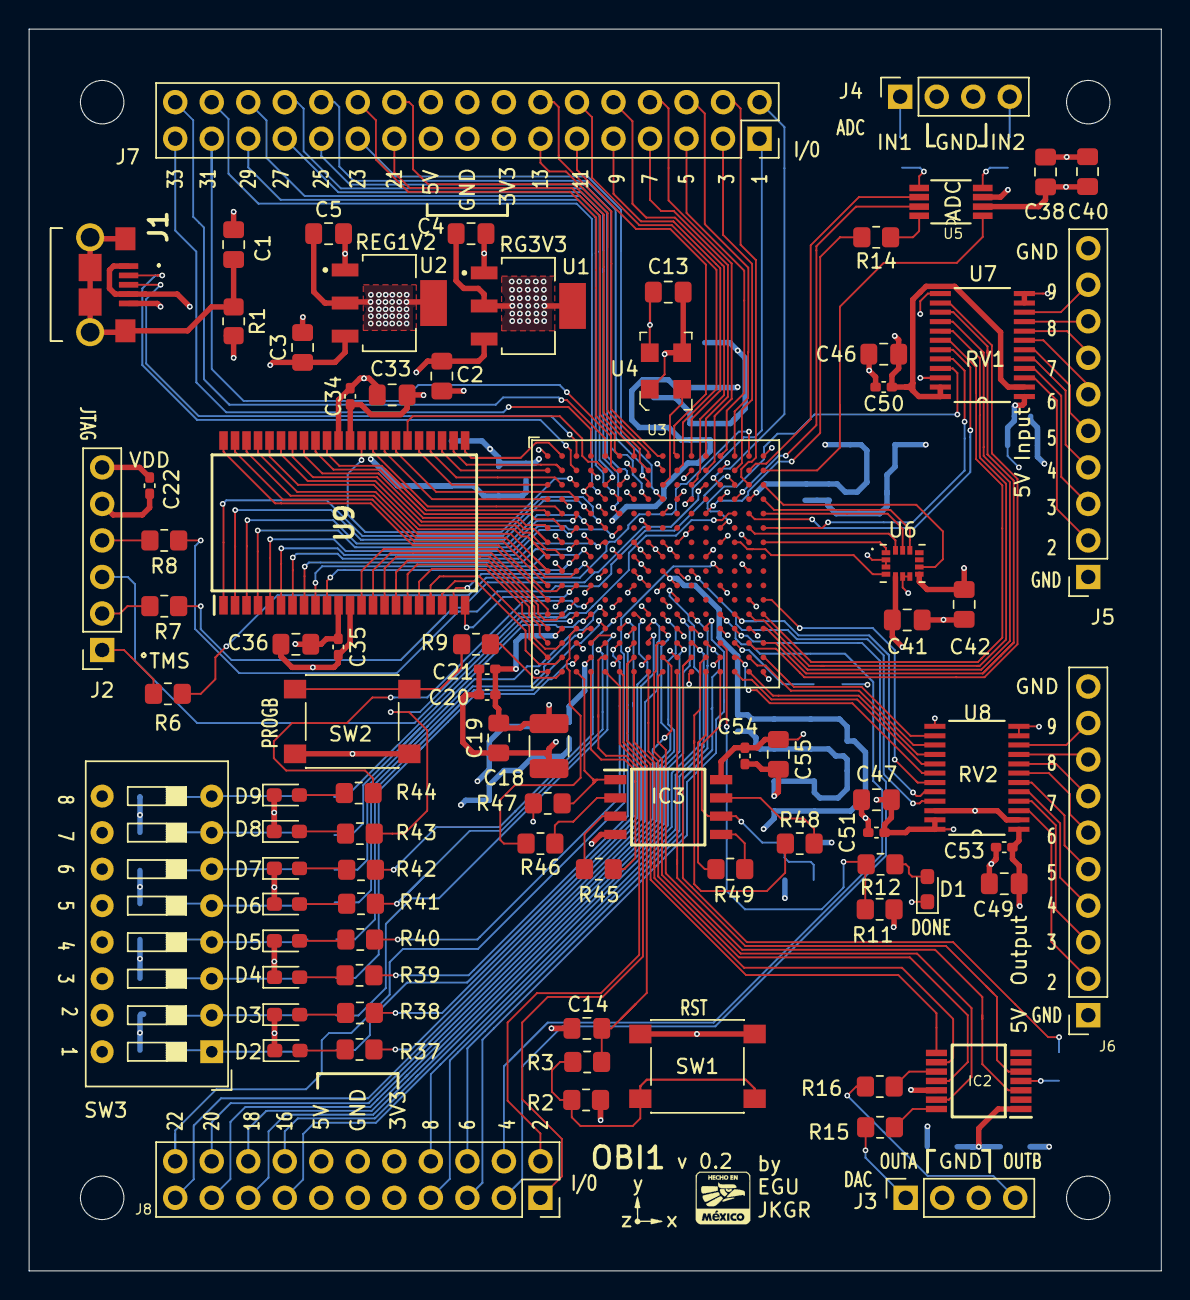
[picture p18: board obi1.kicad_pcb from above]

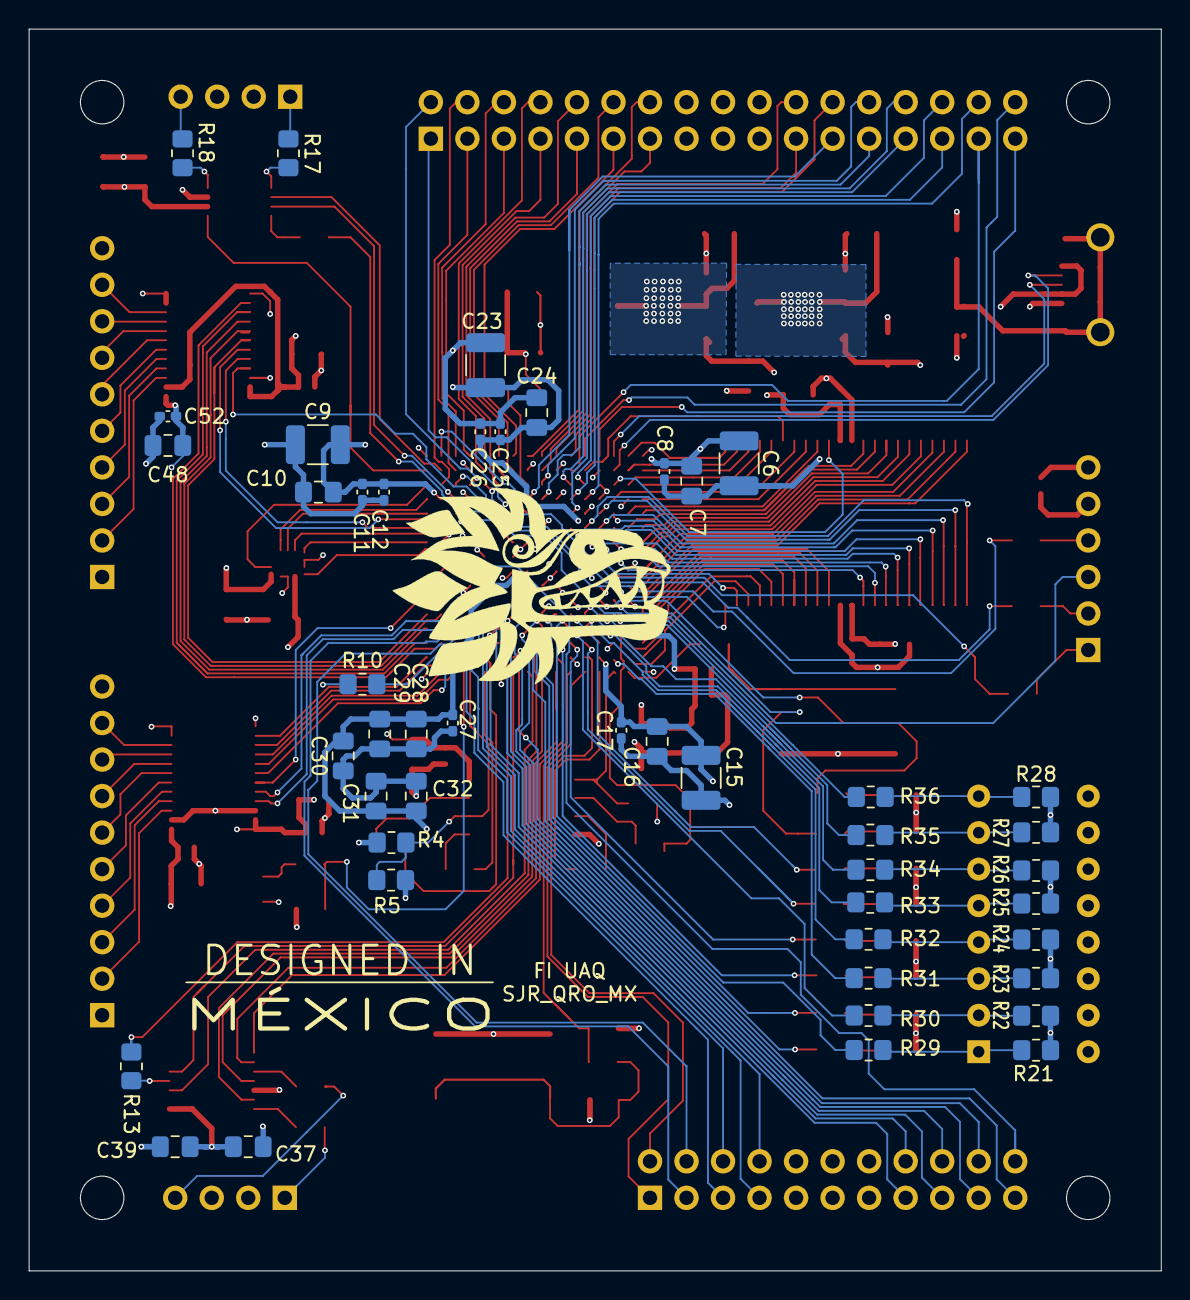
[picture p19: board obi1.kicad_pcb from below]

Board: 4 copper layers, 78.7 x 86.4 mm, 130 parts (46 on the bottom side), 207 nets.
