galan-e/Tarjeta_v02/(commit log)

2021-03-30 Update PCB imu
    [10118193-0001LF.stl, 10118193-0001LF.stp, 101181930001lf.psm, 206-8.stp, 2068.psm, ADC122S625CIMM_NOPB.stl, ADC122S625CIMM_NOPB.stp, ADC_DAC.sch]
2021-04-08 Resize board, change layout, re-route IO pins, new imu added
    [Component_List.ods, FPGA_PartA.sch, FPGA_PartB.sch, IMU.sch, Inputs_Outputs.sch, obi1.kicad_pcb]
2021-04-08 Text in Silk layer adjusted
    [ADC_DAC.sch, FPGA_PartA.sch, FPGA_PartB.sch, FPGA_PartC.sch, FPGA_PartD.sch, Flash_Memory.sch, IMU.sch, Inputs_Outputs.sch]
2021-04-09 Changed RAM by Cypres Model -rebuild symbolic and changed footprint
    [Component_List.ods, FPGA_PartA.sch, FPGA_PartB.sch, POWER_SUPLY.sch, RAM_Memory.sch, obi1.kicad_pcb]
2021-04-09 BOM in proceso
    [Component_List.ods]
2021-04-15 Gerbers Files generated and BOM already done
    [Component_List.ods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]
2021-04-30 IMU changed again, Final IMU= LSM6DSMTR, First Order to OSHPark
    [BOM_Tarjetav2.xlsx, Component_List.ods, FPGA_PartA.sch, FPGA_PartB.sch, IMU.sch, LSM6DSMTR.step, Libro1.xlsx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]
